noodles-zip11/LADAR2-showcase/docs/spec_freeze/02_字段表.md

# 字段表

这份文档同时承担四个作用：

- MCU 点云数据结构表
- 内部 chunk 调试字段表
- CSV 字段表
- 函数表

## 1. MCU 点云数据结构表

| 字段名 | 层级 | 类型 | 单位 | 作用 | 备注 |
| --- | --- | --- | --- | --- | --- |
| `t_sample_us` | MCU 点结构 | `uint32_t` | us | 每点时间戳 | 当前按 UART 帧中心时间估计 |
| `angle_tick` | MCU 点结构 | `uint16_t` | tick | 单圈内角度原始量 | 由连续编码器计数回推并折回单圈 |
| `angle_deg` | MCU 点结构 | `float` | deg | 角度派生量 | 由 `angle_tick` 计算 |
| `distance_cm` | MCU 点结构 | `uint16_t` | cm | 主距离字段 | 已冻结，不再使用 `distance_mm` |
| `quality` | MCU 点结构 | `uint8_t` | 无 | 强度/质量压缩值 | 供过滤与分析使用 |
| `status` | MCU 点结构 | `uint8_t` | 位标志 | 点状态 | 当前仅随成功输出的点发送，已实现使用以 `LIDAR_STATUS_ESTIMATED` 为主 |
| `tmp` | MCU 点结构 | `float` | 传感器换算值 | 温度相关原始量 | 仅保留为 MCU 内部字段，不纳入正式对外字段 |

## 2. 内部 chunk 调试字段表

| 字段名 | 层级 | 类型 | 单位 | 作用 | 备注 |
| --- | --- | --- | --- | --- | --- |
| `luna_chunk_rx_time_us` | MCU 内部 | `uint32_t` | us | chunk 接收锚点 | 仅用于估计与调试，不上 CAN |
| `luna_rx_encoder_tick16` | MCU 内部 | `uint16_t` | tick | 原始 16 位编码器计数 | 原始快照 |
| `luna_rx_encoder_count32` | MCU 内部 | `int32_t` | tick | 连续编码器累计计数 | 用于跨回绕角度回推 |
| `g_zero_offset_count32` | MCU 内部 | `int32_t` | tick | 本次运行零位偏移 | 由第一个成功输出点锁定，开机零位 |
| `g_zero_offset_valid` | MCU 内部 | `uint8_t` | 无 | 零位是否已锁定 | `0` 未锁定，`1` 已锁定 |
| `g_last_rev_id` | MCU 内部 | `int32_t` | 圈号 | 最近一次内部圈号 | 用于圈边界变化检测 |
| `g_rev_transition_cnt` | MCU 内部 | `uint32_t` | 次 | 跨圈统计计数 | `rev_id` 变化时累加 |

## 3. 内部计数器表

| 字段名 | 层级 | 类型 | 单位 | 作用 | 备注 |
| --- | --- | --- | --- | --- | --- |
| `checksum_fail_cnt` | MCU 内部 | `uint32_t` | 次 | 统计校验失败帧 | 对应帧直接丢弃，不输出点 |
| `luna_header_skip_cnt` | MCU 内部 | `uint32_t` | 次 | 统计非帧头字节跳过次数 | MCU parser 内部诊断计数，不上 CAN |
| `luna_resync_cnt` | MCU 内部 | `uint32_t` | 次 | 统计 checksum 失败后的滑动重同步次数 | MCU parser 内部诊断计数，不上 CAN |
| `luna_frame_ok_cnt` | MCU 内部 | `uint32_t` | 次 | 统计成功入点队列的点数 | MCU parser 内部诊断计数，不等同于 CAN 成功发送点数 |
| `amp_low_cnt` | MCU 内部 | `uint32_t` | 次 | 统计低幅值帧 | 对应帧直接丢弃，不输出点 |
| `too_near_cnt` | MCU 内部 | `uint32_t` | 次 | 统计过近帧 | 当前阈值按 `< 28 cm` 处理，直接丢弃 |
| `uart_chunk_drop_cnt` | MCU 内部 | `uint32_t` | 次 | UART chunk 入队失败计数 | 链路级异常，仅计数，不补点、不重发 |
| `parser_overflow_cnt` | MCU 内部 | `uint32_t` | 次 | `parser_buffer` 溢出计数 | 链路级异常，仅计数，不补点、不重发 |
| `lidar_point_drop_cnt` | MCU 内部 | `uint32_t` | 次 | 点队列发送失败计数 | 链路级异常，仅计数，不补点、不重发 |

## 4. CSV 字段表

建议 Linux/CSV 正式字段为：

| 字段名 | 产生位置 | 类型建议 | 单位 | 作用 | 备注 |
| --- | --- | --- | --- | --- | --- |
| `host_rx_time_us` | Linux | `uint64_t` | us | Linux 接收/重组时间 | 不代替 `t_sample_us` |
| `t_sample_us` | MCU -> Linux | `uint32_t` | us | MCU 每点时间戳 | 用于几何与时序恢复 |
| `angle_tick` | MCU -> Linux | `uint16_t` | tick | 角度原始量 | 正式保留，用于检测、回放与复算 |
| `angle_deg` | MCU -> Linux | `float` | deg | 角度派生量 | 正式保留，用于可视化与对外消费 |
| `distance_cm` | MCU -> Linux | `uint16_t` | cm | 主距离字段 | 已冻结 |
| `x_mm` | Linux 派生 | `float` | mm | 平面坐标 X | 由角度和距离计算 |
| `y_mm` | Linux 派生 | `float` | mm | 平面坐标 Y | 由角度和距离计算 |
| `quality` | MCU -> Linux | `uint8_t` | 无 | 质量分析 | 可用于过滤 |
| `status` | MCU -> Linux | `uint8_t` | 位标志 | 点状态 | 包含估计/异常标记 |

## 5. 字段命名冻结结论

- 正式 Linux 时间字段采用 `host_rx_time_us`
- 正式 MCU 时间字段采用 `t_sample_us`
- 正式主距离字段采用 `distance_cm`
- 内部锚点字段 `luna_chunk_rx_time_us` 不进入正式 MCU 点结构
- `distance_mm` 不再作为正式字段出现
- `tmp` 不纳入正式对外字段
- Linux CSV 保留 `angle_tick`
- Linux/对外字段保留 `angle_deg`
- `checksum` / `AMP_LOW` / `TOO_NEAR` 当前不作为成功输出点的 `status` 对外传输，而是采用“丢弃并计数”策略
- 零位冻结为“开机零位”
- 圈边界基于连续编码器计数定义，但 `rev_id` 当前只保留为内部语义

## 6. 函数表

| 函数名 | 所在文件 | 输入 | 输出 | 作用 | 备注/冻结语义 |
| --- | --- | --- | --- | --- | --- |
| `HAL_UARTEx_RxEventCallback` | `Core/Src/main.c` | `UART_HandleTypeDef *`, `Size` | 无 | 在 DMA + IDLE 回调中生成 `LidarChunk` | 采样 `luna_chunk_rx_time_us` 和连续编码器快照 |
| `micros_now` | `Core/Src/main.c` | 无 | `uint32_t` | 读取 MCU 本地微秒时间 | 用于 chunk 时间锚点 |
| `encoder_take_snapshot32` | `Core/Src/main.c` | `curr16` | `int32_t` | 维护连续编码器计数 | 处理 16 位回绕 |
| `luna_input` | `Core/Src/luna.c` | `buffer`, `size`, `chunk_start_index`, `chunk`, `motor_speed_rps` | `uint16_t` 已消费字节数 | 从 `parser_buffer` 中扫描并输出点 | 当前通过 `LunaParseState` 组织帧头搜索、校验、解码和输出；异常策略为 `checksum` / `AMP_LOW` / `TOO_NEAR` 直接丢弃并计数，同时锁定开机零位并更新内部 `rev_id` |
| `angle_from_tick` | `Core/Src/luna.c` | `tick` | `float` | 将 `angle_tick` 转成角度 | 单圈内派生量 |
| `fold_count32_to_rev` | `Core/Src/luna.c` | `count32`, `counts_per_rev` | `int32_t` | 将连续计数折回单圈 | 处理负值与回绕 |
| `LIDAR_SendCAN` | `Core/Src/can.c` | `hcan`, `pHeader`, `aData`, `pTxMailbox`, `point` | `HAL_StatusTypeDef` | 发送两帧 CAN 报文 | 不发送 `luna_chunk_rx_time_us` |
| `LidarParseTask1` | `Core/Src/freertos.c` | FreeRTOS 任务参数 | 无 | 拼接 `parser_buffer` 并调用 `luna_input` | 负责 `chunk_start_index` 传递 |
| `MotorCtrlTask1` | `Core/Src/freertos.c` | FreeRTOS 任务参数 | 无 | 计算 `m1_speed` 并维护 `g_speed_valid` | 首块/起步阶段保护依赖于此 |
