noodles-zip11/LADAR2-showcase/docs/spec_freeze/04_时间戳说明表.md

# 时间戳语义说明表

这份文档定义各时间字段的来源、物理含义和用途边界。

## 1. 时间字段清单

| 字段名 | 产生位置 | 类型 | 单位 | 含义 | 是否对外传输 |
| --- | --- | --- | --- | --- | --- |
| `t_sample_us` | MCU | `uint32_t` | us | 按 UART 帧中心时间估计得到的每点时间戳 | 是 |
| `luna_chunk_rx_time_us` | MCU | `uint32_t` | us | 当前 DMA + IDLE chunk 的接收锚点 | 否 |
| `host_rx_time_us` | Linux | `uint64_t` | us | Linux 接收并完成该点重组时的本地时间 | 仅 Linux/CSV |

## 2. 语义冻结结论

### 2.1 `t_sample_us`

- 来源：MCU
- 当前定义：按 UART 帧中心时间估计得到的每点时间戳
- 用途：
  - 点序恢复
  - 角度配对
  - 点云几何计算
- 边界：
  - 不是 Linux 接收时间
  - 不是传感器真实发光瞬间
  - 当前属于估计值，不是硬件直接测得值

### 2.2 `luna_chunk_rx_time_us`

- 来源：MCU
- 当前定义：在 `HAL_UARTEx_RxEventCallback` 中记录的 chunk 接收锚点
- 用途：
  - 当前 chunk 内每帧 `t_sample_us` 的回推基准
  - 当前 chunk 内每帧 `angle_tick` 的回推基准
  - 调试与诊断
- 边界：
  - 不进入正式 MCU 点结构
  - 不进入 CAN 报文
  - 不进入正式 CSV 字段

### 2.3 `host_rx_time_us`

- 来源：Linux
- 当前定义：Linux 接收并完成该点重组时的本地时间
- 用途：
  - 链路延迟分析
  - 抖动分析
  - 回放与日志对齐
- 边界：
  - 不代替 `t_sample_us`
  - 不参与 MCU 侧几何计算

## 3. 当前代码对应关系

- `HAL_UARTEx_RxEventCallback` 记录 `luna_chunk_rx_time_us`
- `luna_input` 基于 `chunk_start_index`、`luna_chunk_rx_time_us` 和 UART 字节时间回推 `t_sample_us`
- `luna_input` 基于 `luna_rx_encoder_count32` 和 `m1_speed` 回推 `angle_tick`
- `luna_input` 当前通过 `LunaParseState` 状态机组织解析路径；状态机只影响内部解析流程，不改变成功点的时间戳定义
- `luna_input` 对 `checksum` / `AMP_LOW` / `TOO_NEAR` 异常帧采用“直接丢弃并计数”策略，不为其生成正式点时间戳
- `luna_input` 在第一个成功输出点处锁定 `g_zero_offset_count32`
- `luna_input` 基于 `sample_count32 - g_zero_offset_count32` 计算 `angle_tick`
- `luna_input` 基于 `rev_id = floor((sample_count32 - g_zero_offset_count32) / counts_per_rev)` 判断圈边界

## 4. 退化路径说明

- 当首块或 `g_speed_valid == 0` 时：
  - `t_sample_us` 退化为基于 chunk 锚点的估计值
  - `angle_tick` 退化为 chunk 级角度估计
  - `status` 打 `LIDAR_STATUS_ESTIMATED`
- 当当前帧跨 chunk 时：
  - 当前实现也走估计路径
  - `status` 打 `LIDAR_STATUS_ESTIMATED`

## 5. 与对外字段的关系

- `t_sample_us` 是正式对外字段
- `host_rx_time_us` 是正式 Linux/CSV 字段
- `angle_tick` 正式保留，用于检测与复算
- `angle_deg` 正式保留，并继续通过 CAN 对外发送
- `tmp` 不纳入正式对外字段
- 被 `checksum_fail_cnt`、`amp_low_cnt`、`too_near_cnt` 统计到的异常帧不进入正式对外字段集合
- `g_zero_offset_count32`、`g_zero_offset_valid`、`g_last_rev_id`、`g_rev_transition_cnt` 不进入正式对外字段集合
- `uart_chunk_drop_cnt`、`parser_overflow_cnt`、`lidar_point_drop_cnt` 仅作为链路级计数器保留，当前不做补点、不做重发、不做插值

## 6. 零位与圈边界语义

- 零位已冻结为“开机零位”
- 当前实现以第一个成功输出点的 `sample_count32` 作为本次运行零位
- `angle_tick = fold_count32_to_rev(sample_count32 - g_zero_offset_count32, counts_per_rev)`
- `angle_deg` 由该 `angle_tick` 派生
- 圈边界基于相对零位后的连续计数定义
- 当 `rev_id` 变化时，表示跨过圈边界
- `rev_id` 当前仅用于 MCU 内部统计与调试，不作为正式对外字段

## 7. 不建议的写法

- 不要把 `host_rx_time_us` 写成 `host_rx_time`
- 不要把 `host_rx_time_us` 当作测量时间
- 不要把 `luna_chunk_rx_time_us` 当作正式点字段
- 不要把 MCU 本地 us 与 Linux 本地 us 直接做绝对时间比较
