noodles-zip11/LADAR2-showcase/docs/m9/runs/rule_based_v1/replay_sets/can_distance_20260507_141150/can_distance_20260507_141150.m9_report.md

# M9 Rule Quality Gate Appendix Report - can_distance_20260507_141150

- Input: `docs\m8\datasets\replay_sets\can_distance_20260507_141150\can_distance_20260507_141150.csv`
- Filtered CSV: `docs\m9\runs\rule_based_v1\replay_sets\can_distance_20260507_141150\can_distance_20260507_141150.m9_filtered.csv`

## Metrics

| metric | value |
| --- | ---: |
| `total_rows` | 5220 |
| `valid_inputs` | 5220 |
| `kept_points` | 5214 |
| `filtered_points` | 6 |
| `filtered_ratio` | 0.00114943 |
| `status_estimated_count` | 5220 |
| `status_estimated_ratio` | 1 |
| `continuity_issue_count` | 0 |
| `continuity_issue_ratio` | 0 |
| `stability_issue_count` | 6 |
| `stability_issue_ratio` | 0.00114943 |

## Rule Reasons

| reason | count |
| --- | ---: |
| `unstable_angle_bin` | 6 |

## Boundary

- This is rule-level point quality screening, not scene ground truth.
- `status=0x08` is tracked as an estimated flag and is not treated as an alert by itself.
- The stability rule uses repeated distance behavior within angle bins; moving targets or changed scenes still need manual labels.
