noodles-zip11/LADAR2-showcase/docs/m9/runs/rule_based_v1/replay_sets/can_distance_20260509_214813/can_distance_20260509_214813.m9_report.md

# M9 Rule Quality Gate Appendix Report - can_distance_20260509_214813

- Input: `docs\m8\datasets\replay_sets\can_distance_20260509_214813\can_distance_20260509_214813.csv`
- Filtered CSV: `docs\m9\runs\rule_based_v1\replay_sets\can_distance_20260509_214813\can_distance_20260509_214813.m9_filtered.csv`

## Metrics

| metric | value |
| --- | ---: |
| `total_rows` | 15671 |
| `valid_inputs` | 15671 |
| `kept_points` | 15505 |
| `filtered_points` | 166 |
| `filtered_ratio` | 0.0105928 |
| `status_estimated_count` | 15671 |
| `status_estimated_ratio` | 1 |
| `continuity_issue_count` | 44 |
| `continuity_issue_ratio` | 0.00280773 |
| `stability_issue_count` | 141 |
| `stability_issue_ratio` | 0.00899751 |

## Rule Reasons

| reason | count |
| --- | ---: |
| `distance_jump` | 44 |
| `unstable_angle_bin` | 141 |

## Boundary

- This is rule-level point quality screening, not scene ground truth.
- `status=0x08` is tracked as an estimated flag and is not treated as an alert by itself.
- The stability rule uses repeated distance behavior within angle bins; moving targets or changed scenes still need manual labels.
