noodles-zip11/LADAR2-showcase/docs/m9/runs/rule_based_v1/replay_sets/can_distance_20260509_222646/can_distance_20260509_222646.m9_report.md

# M9 Rule Quality Gate Appendix Report - can_distance_20260509_222646

- Input: `docs\m8\datasets\replay_sets\can_distance_20260509_222646\can_distance_20260509_222646.csv`
- Filtered CSV: `docs\m9\runs\rule_based_v1\replay_sets\can_distance_20260509_222646\can_distance_20260509_222646.m9_filtered.csv`

## Metrics

| metric | value |
| --- | ---: |
| `total_rows` | 20881 |
| `valid_inputs` | 20881 |
| `kept_points` | 20597 |
| `filtered_points` | 284 |
| `filtered_ratio` | 0.0136009 |
| `status_estimated_count` | 20881 |
| `status_estimated_ratio` | 1 |
| `continuity_issue_count` | 18 |
| `continuity_issue_ratio` | 0.000862028 |
| `stability_issue_count` | 271 |
| `stability_issue_ratio` | 0.0129783 |

## Rule Reasons

| reason | count |
| --- | ---: |
| `distance_jump` | 18 |
| `unstable_angle_bin` | 271 |

## Boundary

- This is rule-level point quality screening, not scene ground truth.
- `status=0x08` is tracked as an estimated flag and is not treated as an alert by itself.
- The stability rule uses repeated distance behavior within angle bins; moving targets or changed scenes still need manual labels.
