noodles-zip11/LADAR2-showcase/docs/m9/runs/rule_based_v1/replay_sets/can_distance_20260509_223115/can_distance_20260509_223115.m9_report.md

# M9 Rule Quality Gate Appendix Report - can_distance_20260509_223115

- Input: `docs\m8\datasets\replay_sets\can_distance_20260509_223115\can_distance_20260509_223115.csv`
- Filtered CSV: `docs\m9\runs\rule_based_v1\replay_sets\can_distance_20260509_223115\can_distance_20260509_223115.m9_filtered.csv`

## Metrics

| metric | value |
| --- | ---: |
| `total_rows` | 8691 |
| `valid_inputs` | 8691 |
| `kept_points` | 8581 |
| `filtered_points` | 110 |
| `filtered_ratio` | 0.0126568 |
| `status_estimated_count` | 8691 |
| `status_estimated_ratio` | 1 |
| `continuity_issue_count` | 10 |
| `continuity_issue_ratio` | 0.00115062 |
| `stability_issue_count` | 101 |
| `stability_issue_ratio` | 0.0116212 |

## Rule Reasons

| reason | count |
| --- | ---: |
| `distance_jump` | 10 |
| `unstable_angle_bin` | 101 |

## Boundary

- This is rule-level point quality screening, not scene ground truth.
- `status=0x08` is tracked as an estimated flag and is not treated as an alert by itself.
- The stability rule uses repeated distance behavior within angle bins; moving targets or changed scenes still need manual labels.
