noodles-zip11/LADAR2-showcase/docs/m9/runs/rule_based_v1/replay_sets/can_distance_20260510_000136/can_distance_20260510_000136.m9_report.md

# M9 Rule Quality Gate Appendix Report - can_distance_20260510_000136

- Input: `docs\m8\datasets\replay_sets\can_distance_20260510_000136\can_distance_20260510_000136.csv`
- Filtered CSV: `docs\m9\runs\rule_based_v1\replay_sets\can_distance_20260510_000136\can_distance_20260510_000136.m9_filtered.csv`

## Metrics

| metric | value |
| --- | ---: |
| `total_rows` | 33304 |
| `valid_inputs` | 33304 |
| `kept_points` | 32730 |
| `filtered_points` | 574 |
| `filtered_ratio` | 0.0172352 |
| `status_estimated_count` | 33304 |
| `status_estimated_ratio` | 1 |
| `continuity_issue_count` | 93 |
| `continuity_issue_ratio` | 0.00279246 |
| `stability_issue_count` | 491 |
| `stability_issue_ratio` | 0.014743 |

## Rule Reasons

| reason | count |
| --- | ---: |
| `distance_jump` | 90 |
| `isolated_no_neighbor` | 3 |
| `unstable_angle_bin` | 491 |

## Boundary

- This is rule-level point quality screening, not scene ground truth.
- `status=0x08` is tracked as an estimated flag and is not treated as an alert by itself.
- The stability rule uses repeated distance behavior within angle bins; moving targets or changed scenes still need manual labels.
