noodles-zip11/LADAR2-showcase/checkpoint_lidar_can_linux_slim.md

# 基于 CAN 与 Linux 上位机的 2D LiDAR 感知系统 Checkpoint（精简执行版）

**状态：第一版主线收敛**

> 目标：先做成一个可量化、可复现、可面试的工程项目，优先打通核心链路，不在第一阶段引入 MQTT、云端与额外 IoT 包装。

## 0. 项目定位与边界冻结

### 0.1 项目主线
- 旋转式 2D LiDAR 数据采集
- 电机转速控制与角度同步
- CAN 双节点通信
- Linux 上位机实时显示、存储与回放
- 系统稳定性与误差验证

### 0.2 第一阶段必要目标
- 角度同步必须单独设计、验证并写入首页
- 误差来源与预算必须单独列出并持续修正
- 数据链路设计必须明确到帧格式、字段和时间戳
- 上述三项与核心功能同级，不作为“后面再补的文档”

### 0.3 第一阶段明确不做
- MQTT 上云
- 云端平台接入
- 远程控制面板
- 复杂 IoT 展示包装

### 0.4 输出目标
- 360° 单线扫描点云（2D）
- 主控与网关之间稳定 CAN 通信
- Linux 上位机实时显示点云
- 可导出测试数据与误差统计结果

### 0.5 冻结指标（建议）
- 扫描频率：5~10 Hz（可调）
- 角度分辨率：<= 2°
- 点云刷新率：>= 10 FPS（上位机目标）
- 丢包率：< 0.1%
- 连续运行稳定性：>= 4h，目标 8h

### 0.6 交付物
- `README.md`
- 系统框图
- 数据流图
- 时序图
- 测试记录与误差统计表
- 误差来源与预算页
- 数据包与时间戳设计页
- 最小可运行里程碑页

---

## 1. 差异化定位（相对小车项目）

### 1.1 本项目重点
- 感知链路
- 数据通信
- Linux 工具链
- 可观测性与稳定性验证

### 1.2 不重复强调的内容
- 不把项目主卖点放在“小车控制”
- 不把项目讲成“又一个 FreeRTOS 多任务控制系统”
- 不把重点放在花哨功能堆叠

### 1.3 面试表述建议
> 这是一个以感知链路和通信链路为核心的 2D LiDAR 工程项目，重点在于测距采集、角度同步、CAN 分发、Linux 可视化和稳定性验证。

---

## 2. 器件与系统方案 Checkpoint

### 2.1 主控与通信选型
- 主控 MCU：`STM32F407VET6`
  - 关注点：定时器、DMA、CAN 资源、RAM 余量
- CAN 收发器：`SN65HVD230 / VP230`
  - 关注点：3.3V 电平兼容、总线稳定性、ESD 能力
- Linux 侧接入方式：
  - 方案 A：USB-CAN
  - 方案 B：串口桥接到 Linux

### 2.2 传感器与执行器选型
- ToF 传感器：`TF-Luna` 或 `VL53L1X`
- 电机：`N20 + 编码器`
- 滑环：满足旋转供电与信号传输

### 2.3 验收标准
- 输出《选型对比表》
- 输出《接口定义表》
- 输出《电源预算表》

---

## 3. 误差来源与预算（必要页）

### 3.1 目标
- 不只列“误差存在”，而是明确误差来源、估算方法、量级和控制手段
- 初版先给工程预算，实测后再用数据回填修正

### 3.2 ToF 测距误差
- 来源：传感器固有精度、反射率差异、入射角、环境光、盲区与采样噪声
- 预算写法：按传感器典型精度和最差场景分别给出区间
- 记录项：静态白板、深色表面、斜入射表面的距离偏差
- 控制手段：限工作距离、滤除异常值、分材质测试、必要时滑动平均

### 3.3 编码器角度误差
- 来源：编码器线数有限、机械间隙、安装偏心、计数抖动
- 预算写法：
  - 量化分辨率误差：`360 / 编码器每圈总计数`
  - 机械误差单独估计并与量化误差叠加
- 记录项：单圈角度偏差、重复定位误差、零位漂移
- 控制手段：提高计数分辨率、做零位校准、改善安装同轴度

### 3.4 转速波动引入的时间误差
- 来源：电机稳速不足、负载变化、控制环响应滞后
- 影响：距离采样时刻与角度估计不再严格对应，导致点云“扭曲”
- 预算写法：
  - 记录目标转速与实际转速偏差
  - 用采样周期乘角速度波动，折算成角度误差
- 记录项：稳态波动、加减速过渡、长时间漂移
- 控制手段：闭环稳速、固定采样节拍、必要时按时间戳插值修正角度

### 3.5 CAN/串口传输延迟
- 来源：UART 帧时长、DMA 缓冲等待、CAN 仲裁与重发、上位机调度延迟
- 影响：显示和记录端看到的是“延迟后的点”，严重时影响时序分析
- 预算写法：分别统计
  - LiDAR 到 MCU 的串口接收延迟
  - MCU 到 Linux 的 CAN 或串口传输延迟
  - Linux 解析与绘图延迟
- 记录项：平均延迟、最大延迟、抖动范围
- 控制手段：加时间戳、减小缓冲批量、将传输延迟与测量误差分开讨论

### 3.6 坐标转换误差
- 来源：角度误差和距离误差共同投影到 `x/y`
- 预算写法：
  - 近距离时距离误差更显著
  - 远距离时角度误差对横向坐标影响更明显
- 记录项：典型距离点在 `x/y` 平面的偏移量
- 控制手段：在文档中给出误差传播说明，并用实测点验证

### 3.7 建议输出表
- 字段：误差源、理论预算、测试方法、实测均值、实测最大值、改进措施

---

## 4. 数据包与时间戳设计（必要页）

### 4.1 设计原则
- 每一级链路都要有清晰输入和输出格式
- 时间戳尽早产生，尽量在靠近采样的位置生成
- 区分“原始测量时间”和“传输到达时间”

### 4.2 LiDAR 原始帧格式
- 建议字段：帧头、长度、距离值、强度值（若有）、校验、帧尾
- 若传感器已有固定协议：保留原始字段定义，不自行发明新格式
- 记录内容：
  - 原始字节流示例
  - 字段偏移说明
  - 校验失败处理策略

### 4.3 MCU 内部数据结构
```c
typedef struct {
    uint32_t t_sample_us;
    uint16_t angle_tick;
    float angle_deg;
    uint16_t distance_cm;
    uint8_t quality;
    uint8_t status;
} lidar_point_t;
```
- `t_sample_us`：MCU 侧采样或完成配对时的时间戳
- `angle_tick`：保留原始编码器计数，便于回溯
- `angle_deg`：上层使用的角度值
- `status`：标记正常、校验失败、超量程、插值等状态

### 4.4 CAN 报文格式
- 由于 CAN 单帧有效载荷有限，建议拆分为定长字段
- 方案示例：
- 帧 A：`point_id + angle_tick + distance_cm`
  - 帧 B：`point_id + t_sample_us_low + quality + status`
- 如果用 CAN FD，可合并更多字段
- 必须定义：
  - 报文 ID
  - 字节序
  - 缩放规则
  - 丢帧后的重组策略

### 4.5 上位机解析格式
- 内存结构建议字段：
  - `host_rx_time`
  - `t_sample_us`
  - `angle_deg`
- `distance_cm`
  - `x_mm`
  - `y_mm`
  - `quality`
  - `status`
- 文件保存格式建议：CSV 先行，字段固定，便于回放和后处理

### 4.6 时间戳放置建议
- 第一时间戳：MCU 侧，放在距离值与角度值完成配对时生成
- 第二时间戳：Linux 侧，记录报文接收时间
- 不建议只用 Linux 接收时间代替测量时间
- 若资源有限，优先保留 MCU 时间戳

### 4.7 需要写进文档的表
- 《LiDAR 原始帧定义表》
- 《MCU 点云数据结构表》
- 《CAN 报文定义表》
- 《上位机 CSV 字段表》
- 《时间戳语义说明表》

---

## 5. 硬件设计 Checkpoint

### 5.1 原理图
- MCU 最小系统
- 电机驱动
- 编码器输入
- LiDAR 接口
- CAN 接口
- 调试串口与 SWD

### 5.2 PCB 与抗干扰
- 电源区、驱动区、MCU 区、通信区分区
- CAN 差分对优先保证走线质量
- 电机驱动回路与敏感信号隔离
- 关键测试点预留

### 5.3 验收标准
- ERC/DRC 无 Error
- 可稳定下载和串口打印
- 电机启停不导致 MCU 复位

---

## 6. 板级 bring-up Checkpoint

### 6.1 上电自检
- 检查 3.3V/5V 纹波
- 检查静态电流与温升
- 检查下载、串口、调试接口

### 6.2 外设逐项调通
- LiDAR 数据接收
- PWM 输出
- 编码器测速
- CAN 收发
- 电机启停与调速

### 6.3 验收标准
- 每个模块都有最小测试程序
- 每个模块都有日志或截图记录

---

## 7. 固件主线 Checkpoint

### 7.1 驱动层
- UART DMA + IDLE 接收 LiDAR 数据
- 编码器测速
- PWM 调速
- CAN 收发与过滤器

### 7.2 最小任务集
- `MotorCtrlTask`
- `LidarParseTask`
- `CanTxTask`
- `DiagLogTask`（可选但推荐）

### 7.3 核心规则
- 中断与任务之间仅通过 Queue/StreamBuffer 传递数据
- 驱动接口统一：`init/start/read/write`
- 错误码和状态码可追踪

### 7.4 验收标准
- 无明显共享变量竞争
- 能输出队列高水位或缓冲区占用统计
- 异常帧可识别并丢弃

---

## 8. 感知与同步 Checkpoint

### 8.1 LiDAR 数据解析
- 解析距离数据帧
- 处理错帧、截断帧、校验错误
- 对异常值做过滤

### 8.2 电机转速控制
- 实现稳定转速控制
- 记录目标转速与实际转速偏差
- 输出调参记录

### 8.3 角度同步
- 用编码器或等效方法建立距离值与角度的对应关系
- 说明一圈采样内的角度映射方法
- 明确同步误差来源
- 说明是否使用时间戳插值或固定节拍配对

### 8.4 坐标变换
- 极坐标转直角坐标
- 输出点云数据结构供 CAN 或上位机使用

### 8.5 验收标准
- 输出滤波前后对比图
- 输出转速响应曲线
- 输出角度同步说明与误差预算

---

## 9. CAN 通信 Checkpoint

### 9.1 最小网络结构
- 节点 1：LiDAR 主控节点
- 节点 2：Linux 侧接入节点或网关节点

### 9.2 通信内容
- 角度
- 距离
- 状态码
- 错误计数或诊断字段
- 必要时间戳字段

### 9.3 关键验证项
- 标准帧稳定收发
- 过滤器命中正确
- 连续传输下无明显丢帧
- 异常帧和总线错误可记录

### 9.4 验收标准
- 输出 CAN 报文定义表
- 输出抓包记录或日志
- 输出错误计数统计

---

## 10. Linux 上位机 Checkpoint

### 10.1 数据接收工具
- 技术栈建议：`Python + PySerial` 或 `python-can`
- 功能：
  - 接收数据
  - 解析数据帧
  - 保存 CSV

### 10.2 实时显示
- 技术栈建议：`PyQtGraph` 优先，`Matplotlib` 作为简化备选
- 功能：
  - 2D 点云实时显示
  - 刷新率统计
  - 支持回放历史数据

### 10.3 工程化交付
- `requirements.txt`
- 一键运行脚本
- 示例数据文件
- 基本使用说明

### 10.4 验收标准
- 新环境 30 分钟内可复现演示
- 可完成“接收-显示-存储-回放”闭环

---

## 11. 最小可运行里程碑（必要页）

### 11.1 M1：LiDAR 原始距离采集成功
- 能稳定收到原始数据帧
- 能识别错帧和校验失败
- 输出原始日志样例

### 11.2 M2：电机稳速 + 编码器测速
- 电机能稳定转动
- 实际转速可测可画曲线
- 能说明稳态误差与波动范围

### 11.3 M3：距离-角度配对成功
- 每个距离值都能关联角度值
- 能输出一圈内的点云原始列表
- 能解释配对时刻和时间戳语义

### 11.4 M4：Linux 闭环
- 主控稳定发、接收端稳定收
- 报文格式固定并可抓包验证
- 关键状态位可见
- 能实时解析并显示 2D 点云
- 能保存 CSV
- 能回放历史数据

### 11.5 M6：长稳与压测
- 连续运行 >= 4h
- 记录丢包、刷新率、温升和异常恢复
- 输出测试结论

### 11.6 执行原则
- 每个里程碑都必须有截图、日志或数据文件作为完成证据
- 未完成上一个里程碑，不进入下一个里程碑的复杂扩展

---

## 12. 系统联调与压测 Checkpoint

### 12.1 长稳测试
- 连续运行 >= 4h，目标 8h
- 记录：
  - 丢包率
  - 转速波动
  - 点云刷新率
  - 错误恢复次数
  - 温升

### 12.2 场景测试
- 静态目标
- 移动目标
- 不同材质反射面

### 12.3 失效模式验证
- 电源抖动
- CAN 干扰
- 串口噪声
- 传感器异常数据

### 12.4 验收标准
- 无崩溃、死锁、严重漂移
- 错误可观测、可记录、可恢复

---

## 13. 简历与面试交付 Checkpoint

### 13.1 必备内容
- 一张系统框图
- 一张数据流图
- 一张点云显示截图
- 一页测试结果总结
- 一段 1~3 分钟演示视频

### 13.2 简历表述建议
> 设计并实现基于 STM32 的 2D LiDAR 感知系统，完成 LiDAR 数据采集、电机角度同步、CAN 节点通信与 Linux 上位机实时点云显示，并通过长稳与误差测试验证系统可靠性。

### 13.3 面试重点准备
- 为什么保留 CAN、不急着上云
- 角度同步怎么做
- 丢包和错帧如何处理
- 时间戳为什么这样设计
- Linux 上位机为什么这样设计
- 如何证明系统稳定

---

## 14. 后续扩展（第一阶段完成后再加）

### 14.1 通信扩展
- MQTT 网关桥接
- 云端数据上传
- 多节点 CAN 网络扩展

### 14.2 AI 扩展策略（第二阶段，Linux 侧优先）
- AI 第一落点放在 Linux 上位机，不在第一阶段直接部署到 MCU
- 先利用已有的 `CSV / 实时接收 / 存储 / 回放` 链路做数据集、离线训练和验证
- 先证明 AI 功能确实优于固定阈值或简单规则，再考虑轻量化下沉部署

#### 14.2.1 第一优先级：点级质量判断
- 目标：判断单点或局部点是否有效、异常或可疑
- 推荐输入特征：
  - 当前距离
  - 前后点差分
  - 连续几圈是否稳定
  - `quality` 或幅值
  - 邻域连续性
  - 转速波动或时间戳相关特征
- 输出建议：
  - 二分类：有效 / 无效
  - 或三分类：有效 / 可疑 / 无效
- 选择原因：
  - 数据最好采
  - 标签定义最清楚
  - 可直接和规则滤波做对比
  - 最适合后续轻量模型或 MCU 端部署尝试

#### 14.2.2 第二优先级：障碍物区域判断 / 风险分区
- 不直接判断单个点，而是判断前方某一小片区域是否危险
- 可将前方按角度划分成若干扇区，再根据局部点云特征输出：
  - 安全
  - 可疑
  - 危险
- 该方向适合后续往室内低速设备的障碍感知节点扩展
- 前提是点级清洗已经稳定，否则上层判断会被底层噪声拖垮

#### 14.2.3 第三优先级：简单目标检测 / 动静态区分
- 该方向接近点云聚类、简单目标检测、障碍物跟踪
- 可让模型或规则判断：
  - 这团点像不像真实障碍物
  - 这是静态背景还是移动目标
  - 这一圈和上一圈相比是否出现异常变化
- 该方向门槛更高，因为需要更稳定的点云、更好的连续帧数据和更明确的标签定义
- 因此放在点级质量判断和风险分区之后

#### 14.2.4 模型与部署原则
- Linux 侧优先，先做离线验证，再决定是否做实时推理
- 先做规则基线，再尝试轻量模型
- 模型优先考虑：
  - Logistic Regression
  - 小型决策树 / 随机森林
  - LightGBM / XGBoost 小模型
  - Tiny MLP
- 暂不优先考虑重型深度学习模型
- 只有在 Linux 侧验证出明确价值后，才考虑 MCU 侧轻量化部署

### 14.3 工具扩展
- 更完整的 Linux GUI
- 参数在线配置
- 历史数据管理与分析面板

### 14.4 原则
- 只有在核心链路稳定后才增加这些内容
- 所有扩展项都不能影响第一阶段主线交付

---

## 15. 执行顺序建议

1. 先打通 LiDAR 原始采集。
2. 再完成电机稳速和编码器测速。
3. 然后完成距离-角度配对与时间戳设计。
4. 再完成 CAN 双节点稳定通信。
5. 然后做 Linux 接收、显示、存储、回放。
6. 再做长稳测试、误差统计和失效验证，积累可回放数据。
7. 第二阶段先在 Linux 侧建立“录制-回放-标注-评估”闭环。
8. AI 第一优先级先做点级质量判断。
9. AI 第二优先级再做障碍物区域判断 / 风险分区。
10. AI 第三优先级最后再考虑简单目标检测 / 动静态区分。
11. MQTT、云端、IoT 包装全部放到更后面的扩展阶段。
