noodles-zip11/LADAR2-showcase/docs/m3/05_错误统计与恢复样例.md

# M3 错误统计与恢复样例

## 1. 结论

当前已经归档 MCU 侧故障态与 ACK fault recovery `DiagLogTask` 样例，能够证明：

- `DiagLogTask` 的 M3 CSV 已在 MCU 侧实际输出
- CAN 发送失败计数会持续增长
- CAN 错误位图和错误中断计数会持续刷新
- 恢复后 `can_tx_ok_point_cnt` 重新增长，错误计数停止增长

本次故障注入方式没有触发 Bus-Off，因此没有证明：

- `HAL_CAN_ERROR_BOF` 出现
- `can_recovery_cnt` 在 Bus-Off 恢复后增加

此外，当前已经归档一段 MCU 正常态 `DiagLogTask` 样例，可作为正常链路对照。

因此，本页当前可以作为“正常态 + ACK 故障态 + ACK 恢复态样例页”。`Bus-Off -> recovery` 不作为 M3 当前收尾证据。

## 2. 当前归档文件

- `docs/m3/data/diag_m3_fault_20260328_excerpt.csv`
- `docs/m3/data/diag_m3_normal.csv`
- `docs/m3/data/diag_m3_ack_fault_recovery_excerpt.csv`

## 3. 样例片段

```text
tick_ms,lidar_chunk_q_depth,lidar_chunk_q_hwm,uart_chunk_drop_cnt,uart_chunk_oversize_cnt,parser_overflow_cnt,checksum_fail_cnt,amp_low_cnt,too_near_cnt,lidar_point_q_depth,lidar_point_q_hwm,lidar_point_drop_cnt,can_tx_ok_point_cnt,can_tx_fail_point_cnt,can_tx_fail_frame_cnt,can_last_error_code,can_error_irq_cnt,can_bus_off_cnt,can_recovery_cnt
190070,0,1,0,0,0,0,8,21,0,1,0,5576,13430,13430,0x00200063,503636,0,0
191076,0,1,0,0,0,0,8,21,0,1,0,5576,13531,13531,0x00200063,507418,0,0
192082,0,1,0,0,0,0,8,21,0,1,0,5576,13632,13632,0x00200063,511200,0,0
```

## 4. 样例解读

从这段故障态样例可以直接看到：

- `can_tx_ok_point_cnt` 固定在 `5576`
- `can_tx_fail_point_cnt` 持续增加
- `can_tx_fail_frame_cnt` 持续增加
- `can_error_irq_cnt` 持续增加
- `can_last_error_code` 持续保持为非零值 `0x00200063`
- `can_bus_off_cnt=0`
- `can_recovery_cnt=0`

这说明当前故障更像是“持续错误风暴”而不是“已进入并退出 Bus-Off”的闭环。

## 5. `can_last_error_code` 粗解

当前样例中的：

- `0x00200063`

至少包含以下错误位：

- `0x00000001`：`HAL_CAN_ERROR_EWG`
- `0x00000002`：`HAL_CAN_ERROR_EPV`
- `0x00000020`：`HAL_CAN_ERROR_ACK`
- `0x00000040`：`HAL_CAN_ERROR_BR`
- `0x00200000`：`HAL_CAN_ERROR_PARAM`

这说明当前链路中至少出现了：

- Error Warning
- Error Passive
- ACK 错误
- Bit Recessive 错误
- 参数错误位

当前样例中没有看到：

- `HAL_CAN_ERROR_BOF`

因此本样例不能用于证明 `Bus-Off -> recovery`。

## 6. ACK fault -> recovery 样例

文件：

- `docs/m3/data/diag_m3_ack_fault_recovery_excerpt.csv`

恢复段片段：

```text
522090,0,1,0,0,0,0,0,14,0,1,0,3552,48870,48870,0x00200023,1867497,0,0
529132,0,1,0,0,0,0,0,14,0,1,0,4260,48870,48870,0x00200023,1867497,0,0
```

故障段片段：

```text
531144,0,1,0,0,0,0,0,14,0,1,0,4335,48997,48997,0x00200023,1872423,0,0
548246,0,1,0,0,0,0,0,14,0,1,0,4335,50716,50716,0x00200023,1938710,0,0
```

再次恢复段片段：

```text
551264,0,1,0,0,0,0,0,14,0,1,0,4365,50990,50990,0x00200023,1949121,0,0
561324,0,1,0,0,0,0,0,14,0,1,0,5376,50990,50990,0x00200023,1949121,0,0
```

解读：

- 恢复段：`can_tx_ok_point_cnt` 增长，`can_tx_fail_point_cnt`、`can_tx_fail_frame_cnt`、`can_error_irq_cnt` 停止增长
- 故障段：`can_tx_ok_point_cnt` 基本停住，`can_tx_fail_point_cnt`、`can_tx_fail_frame_cnt`、`can_error_irq_cnt` 持续增长
- 再次恢复段：`can_tx_ok_point_cnt` 重新增长，错误计数再次停止增长

## 7. 当前边界

本页已经覆盖：

- 正常态统计样例
- 故障态统计样例
- ACK fault -> recovery 板级实测样例

本页仍未覆盖：

- Bus-Off recovery 行为；本次故障注入方式未触发 `HAL_CAN_ERROR_BOF`

## 7. 正常态对照样例

文件：

- `docs/m3/data/diag_m3_normal.csv`

片段：

```text
24128,0,1,0,0,0,0,0,3,0,1,0,2378,0,0,0x00000000,0,0,0
25133,0,1,0,0,0,0,0,3,0,1,0,2478,0,0,0x00000000,0,0,0
26137,0,1,0,0,0,0,0,3,0,1,0,2579,0,0,0x00000000,0,0,0
```

解读：

- `can_tx_ok_point_cnt` 持续增长
- `can_tx_fail_point_cnt=0`
- `can_tx_fail_frame_cnt=0`
- `can_last_error_code=0x00000000`
- `can_error_irq_cnt=0`
- `can_bus_off_cnt=0`
- `can_recovery_cnt=0`

这说明正常链路下 MCU 侧 M3 诊断日志口径是稳定且自洽的。

当前 M3 收口采用 ACK fault -> recovery 证据，不再把 Bus-Off recovery 作为当前阶段阻塞项。
