noodles-zip11/LADAR2-showcase/docs/m5/05_current_run_summary.md

# M5 当前实测基线

## 1. 本轮结论

截至 2026-05-07，M5 已完成一轮可用的短长稳基线记录。

本轮实际运行约 1h42min，作为 M6 几何质量与同步优化前的短长稳基线接受。当前不再补跑 2h，对外不写成“已完成 2h 长稳”。

## 2. 运行信息

| 项目 | 值 |
| --- | --- |
| run_id | `m5_20260507_145736` |
| 运行目录 | `docs/m5/runs/m5_20260507_145736/` |
| 开始时间 | `2026-05-07T14:57:36` |
| 结束时间 | `2026-05-07T16:39:32` |
| 实际运行时长 | `6116.0 s` |
| 数据有效时长 | `6115.7 s` |
| 采集点数 | `612466` |

## 3. 核心指标

| 指标 | 本次值 |
| --- | ---: |
| 点云刷新率 | `100.147 Hz` |
| CAN 重组丢包事件 | `7` |
| CAN 重组丢包率 | `0.001143%` |
| 重组 timeout | `7` |
| overwrite_a | `0` |
| overwrite_b | `0` |
| 结束 pending 半帧 | `0` |
| 平均转速 | `9.026 rpm` |
| 转速标准差 | `1.485 rpm` |
| 转速 p95 偏差 | `3.887 rpm` |

## 4. 证据文件

- `docs/m5/runs/m5_20260507_145736/m5_long_run_report.md`
- `docs/m5/runs/m5_20260507_145736/baseline_metrics.md`
- `docs/m5/runs/m5_20260507_145736/test_record.md`
- `docs/m5/runs/m5_20260507_145736/data/can_points_m5_20260507_145736.csv`
- `docs/m5/runs/m5_20260507_145736/data/can_points_m5_20260507_145736_summary.txt`
- `docs/m5/runs/m5_20260507_145736/data/m5_interval_samples.csv`
- `docs/m5/runs/m5_20260507_145736/logs/m5_events.log`

## 5. 边界说明

- 本轮不接 UART3。
- 本轮不做温升统计。
- 本轮不证明盒内几何形状正确；盒内点云近场形状只用于观察扫描是否持续。
- 几何形状、直线度、闭合度和环境轮廓质量放到 M6。
