noodles-zip11/LADAR2-showcase/docs/reacquaintance/00_快速回顾索引.md

# LADAR2 快速回顾索引

更新时间：2026-04-20

这组文档用于帮你在一个月没看项目后快速恢复上下文。内容综合了三类来源：

- 当前仓库代码：`Core/Src/*.c`、`Core/Inc/*.h`、`can_recv4.py`
- 已归档文档：`docs/spec_freeze/`、`docs/m1/`、`docs/m2/`、`docs/m3/`、`docs/m4/`
- Notion 计划：`LADAR2 实施计划（按当前进展收口版）`

Notion 源页：

- <https://www.notion.so/32dde3aefb83818e8fcfd1360c409870>

## 阅读顺序

1. [01 数据流动链路](./01_数据流动链路.md)
2. [02 MCU 代码逻辑](./02_MCU代码逻辑.md)
3. [03 电机控制逻辑](./03_电机控制逻辑.md)
4. [04 当前进度与下一步](./04_当前进度与下一步.md)

如果只想先恢复全局印象，先看这页和 `01_数据流动链路.md`。如果要马上改代码，优先看 `02_MCU代码逻辑.md` 和 `03_电机控制逻辑.md`。

## 当前一句话状态

LADAR2 当前已经具备主链路闭环：LiDAR 通过 UART2 DMA 进入 MCU，MCU 结合编码器和电机速度估算每点时间/角度，再通过 CAN 双帧发给 Linux，上位机完成双帧重组、CSV 存储、CSV 回放和 XY 2D 点云显示。

项目现在的主要工作不是继续堆新功能，而是收口证据和文档：补 M3 恢复证据、统一 Linux 脚本入口命名、做 M5 长稳测试、再推进 M6/M7 的几何质量和展示材料。

## 核心文件地图

| 模块 | 文件 | 作用 |
| --- | --- | --- |
| 主入口和 ISR | `Core/Src/main.c` | HAL 初始化后进入 FreeRTOS；UART2 DMA IDLE 回调里生成 `LidarChunk` |
| FreeRTOS 任务 | `Core/Src/freertos.c` | 创建队列和任务；串联解析、电机、CAN、诊断任务 |
| LiDAR 解析 | `Core/Src/luna.c` | 通过 `LunaParseState` 状态机解析 TF-Luna 9 字节帧，过滤异常，估算 `t_sample_us` / `angle_tick` |
| 点结构 | `Core/Inc/main.h` | 定义 `lidar_point_t` 和 `LidarChunk` |
| CAN 协议 | `Core/Src/can.c` | 把一个点拆成 `0x123` / `0x124` 两帧发送 |
| 电机输出 | `Core/Src/motor.c` | 根据正负 PWM 设置方向 GPIO 和 TIM1 CCR |
| PID | `Core/Src/pid.c` | 速度闭环 PID，带输出限幅和抗积分饱和 |
| Linux 上位机 | `can_recv4.py` | SocketCAN 实时接收、双帧重组、CSV、回放、2D 点云 |
| 规格冻结 | `docs/spec_freeze/` | 字段、报文、时间戳和单位语义冻结 |
| 里程碑证据 | `docs/m1/` 到 `docs/m4/` | 采集、电机、CAN、Linux 闭环证据 |

## 当前最需要记住的设计约定

- 正式距离字段是 `distance_cm`，不是 `distance_mm`。
- MCU 时间是 `t_sample_us`，Linux 接收/重组时间是 `host_rx_time_us`，两者不能混用。
- `angle_tick` 是相对开机零位的单圈编码器计数，`angle_deg` 是由它派生出的角度。
- CAN 每个点发两帧：`0x123` 发距离/角度/质量，`0x124` 发时间/原始角度/状态。
- 当前异常帧策略是丢弃并计数：校验失败、低幅值、过近都不输出点。
- LiDAR parser 当前已具备显式状态机、checksum 失败滑动 1 字节重同步和内部诊断计数。
- 电机当前是单圈换向的双向闭环扫描，不是一直单方向旋转。
- Linux 侧已经具备实时接收和回放能力，文档入口已和当前 `can_recv4.py` 对齐。
