noodles-zip11/LADAR2-showcase/docs/m5/runs/m5_20260507_144251/baseline_metrics.md

# M5 基线指标页

| 指标 | 本次值 | 建议基线/判定 |
| --- | ---: | --- |
| 连续运行时长 | 0.0 s | 不少于 14400 s |
| CAN 重组点数 | 8 | 非 0，且运行中持续增长 |
| 丢包率 | 0.000000% | 先记录为基线；后续 M6/M7 不应显著变差 |
| 刷新率 | 1600.000 Hz | 先记录为基线；后续优化需对比 |
| 点间隔 p95 | 2.000 ms | 先记录为基线 |
| 最大点间隔 | 2.000 ms | 用于定位卡顿/断流 |
| 平均转速 | 4.392 rpm | 先记录为基线 |
| 转速标准差 | 0.468 rpm | 先记录为基线 |
| 转速 p95 偏差 | 0.741 rpm | 先记录为基线 |
