noodles-zip11/LADAR2-showcase/docs/m5/runs/m5_20260507_145736/baseline_metrics.md

# M5 基线指标页

| 指标 | 本次值 | 建议基线/判定 |
| --- | ---: | --- |
| 连续运行时长 | 6116.0 s | 短长稳基线；严格 4h 需不少于 14400 s |
| CAN 重组点数 | 612466 | 非 0，且运行中持续增长 |
| 丢包率 | 0.001143% | 先记录为基线；后续 M6/M7 不应显著变差 |
| 刷新率 | 100.147 Hz | 先记录为基线；后续优化需对比 |
| 点间隔 p95 | 18.482 ms | 先记录为基线 |
| 最大点间隔 | 1484.492 ms | 用于定位卡顿/断流 |
| 平均转速 | 9.026 rpm | 先记录为基线 |
| 转速标准差 | 1.485 rpm | 先记录为基线 |
| 转速 p95 偏差 | 3.887 rpm | 先记录为基线 |
