noodles-zip11/LADAR2-showcase/docs/m7/README.md

# M7 面试交付与 V1 封板

> 日期：2026-05-10
> 范围：第一阶段验收交付包
> 状态：文档包已准备；演示视频录制和 Git 标签仍需要用户执行

## 1. 目标

M7 的目标是把 LADAR2 第一阶段整理成可复现、可展示、可讲清楚的正式作品。这个阶段不再扩大功能范围，而是把已经完成的主链路、协议、证据、测试结论和边界统一收口到一个入口清晰的交付包。

## 2. 交付物索引

| 交付物 | 文件 | 状态 |
| --- | --- | --- |
| 根目录 README：运行方式、目录结构、依赖、演示路径和边界 | `README.md` | 已完成 |
| 系统框图、数据流图、时序图、CAN 表、CSV 字段表、时间戳表 | `docs/m7/01_system_diagrams.md` | 已完成 |
| 1 页项目总览 | `docs/m7/02_project_overview_one_page.md` | 已完成 |
| 面试讲稿与问答提纲 | `docs/m7/03_interview_talk_track.md` | 已完成 |
| 1 到 3 分钟演示视频脚本 | `docs/m7/04_demo_video_script.md` | 待录制 |
| V1 发布记录 | `docs/m7/05_v1_release_record.md` | 候选版已准备 |
| 简历版项目条目 | `docs/m7/06_resume_project_bullets.md` | 已完成 |

## 3. 证据来源

| 主题 | 主要证据 |
| --- | --- |
| 原始 LiDAR 与 CAN 采集 | `docs/m1/` |
| 电机稳速与角度配对 | `docs/m2/` |
| CAN 协议与诊断 | `docs/m3/`、`docs/spec_freeze/03_报文表.md` |
| 上位机接收、CSV、回放、UI | `docs/m4/` |
| 长稳基线 | `docs/m5/05_current_run_summary.md` |
| 几何质量 | `docs/m6/runs/m6_manual/geometry_metrics.md` |
| MQTT/plugin 扩展收口 | `docs/mqtt_plugin_refactor/08_m6_5_verification_record.md` |

## 4. M7 完成判断

从文档和面试交付角度看，M7 已经具备完成条件：

- README 已经说明项目定位、目录结构、运行命令、协议入口、演示路径和已知边界。
- 系统框图、数据流图和时序图已经集中到 M7 交付包。
- 验收叙述基于 M1-M6.5 已有证据，不伪造新测试结论。
- 面试讲稿覆盖角度同步、CAN 设计、上位机设计、稳定性证据和误差来源。
- 简历版项目条目已经压缩为可直接投递的工程表达，并保留 V1 边界。
- 视频脚本已经准备好，不需要再改代码即可录制。

## 5. 需要用户完成的事项

以下事项需要真实录屏、用户审阅或 Git 决策：

- 按 `04_demo_video_script.md` 录制 1 到 3 分钟演示视频。
- 审阅 M7 文档，确认表述符合你的面试风格。
- 提交最终 M7 文档包。
- 提交后再打标签，建议标签名：`v1.0.0`。

不要在提交这些文档前打标签，否则标签会指向不包含 M7 交付包的旧提交。
