noodles-zip11/LADAR2-showcase/docs/m5/runs/README.md

# M5 运行证据包目录

每次运行 `tools/m5_long_run.py` 会在本目录下创建：

```text
m5_YYYYMMDD_HHMMSS/
```

不要手工覆盖历史运行目录。短测、失败测试和正式 4h 测试都保留，方便复盘。
