noodles-zip11/LADAR2-showcase/docs/m8/datasets/known_scenes/m6_box_far_01/README.md

# M8 数据集条目

## 1. 基本信息

| 项目 | 内容 |
| --- | --- |
| 数据集名称 | `m6_box_far_01` |
| 来源 CSV | `LOCAL_USER_HOME\Desktop\雷达\LADAR2\docs\m6\runs\m6_manual\data\repeat_far_01.csv` |
| 场景标签 | `static_box` |
| 标签说明 | M6 known scene: far static box repeat 01 |
| 分类 | `known_scenes` |

## 2. 文件清单

| 文件 | 说明 |
| --- | --- |
| `m6_box_far_01.csv` | 原始 CSV 副本 |
| `m6_box_far_01.labels.csv` | 标签模板 |
| `m6_box_far_01.analysis.md` | 离线分析报告 |

## 3. 分析摘要

| 指标 | 结果 |
| --- | --- |
| `total_rows` | 3268 |
| `valid_points` | 3268 |
| `duration_s` | 33.4878 |
| `estimated_rate_hz` | 97.5579 |
| `distance_cm_median` | 34 |
| `distance_cm_p95` | 39 |
| `status_distribution` | {8: 3268} |
| `status_alert_count` | 0 |
| `estimated_flag_ratio` | 1 |
| `near_obstacle_count` | 3268 |
| `too_near_count` | 848 |
| `angle_coverage_ratio` | 1 |
| `outline_spread_cm_median` | 5.8 |

## 4. 采集摘要

| 字段 | 值 |
| --- | --- |
| `csv_path` | `LOCAL_USER_HOME\Desktop\雷达\LADAR2\docs\m6\runs\m6_manual\data\repeat_far_01.csv` |
| `generated_at` | `2026-05-10T15:45:34` |
| `reassembly_ok_point_cnt` | `3268` |
| `reassembly_timeout_point_cnt` | `1` |
| `reassembly_overwrite_a_cnt` | `0` |
| `reassembly_overwrite_b_cnt` | `0` |
| `pending_frame_cnt` | `0` |
| `reassembly_timeout_ms` | `50` |

## 5. 标签状态

当前标签为 `static_box`。未知场景保持 `unlabeled`；只有 M6 这类来源明确的数据才写入具体场景标签。
