noodles-zip11/LADAR2-showcase/docs/m8/datasets/replay_sets/can_distance_20260507_141150/README.md

# M8 数据集条目

## 1. 基本信息

| 项目 | 内容 |
| --- | --- |
| 数据集名称 | `can_distance_20260507_141150` |
| 来源 CSV | `LOCAL_USER_HOME\Desktop\雷达\LADAR2\can_distance_20260507_141150.csv` |
| 场景标签 | `unlabeled` |
| 标签说明 | unknown replay capture; scene is not claimed |
| 分类 | `replay_sets` |

## 2. 文件清单

| 文件 | 说明 |
| --- | --- |
| `can_distance_20260507_141150.csv` | 原始 CSV 副本 |
| `can_distance_20260507_141150.labels.csv` | 标签模板 |
| `can_distance_20260507_141150.analysis.md` | 离线分析报告 |

## 3. 分析摘要

| 指标 | 结果 |
| --- | --- |
| `total_rows` | 5220 |
| `valid_points` | 5220 |
| `duration_s` | 51.4775 |
| `estimated_rate_hz` | 101.384 |
| `distance_cm_median` | 49 |
| `distance_cm_p95` | 114 |
| `status_distribution` | {8: 5220} |
| `status_alert_count` | 0 |
| `estimated_flag_ratio` | 1 |
| `near_obstacle_count` | 2803 |
| `too_near_count` | 26 |
| `angle_coverage_ratio` | 1 |
| `outline_spread_cm_median` | 10 |

## 4. 采集摘要

未找到同名 `_summary.txt`。

## 5. 标签状态

当前标签为 `unlabeled`。未知场景保持 `unlabeled`；只有 M6 这类来源明确的数据才写入具体场景标签。
