noodles-zip11/LADAR2-showcase/docs/m3/04_联调与抓包记录.md

# M3 联调与抓包记录

## 1. 结论

截至 2026-03-28，M3 已完成一轮 Linux 侧正常链路联调，当前证据能够证明：

- MCU 正在持续发送 `0x123` 与 `0x124`
- Linux 接收端已经按 `seq` 成功完成双帧重组
- 重组后的点级 CSV 已经稳定落盘
- 最小重组统计已经能够输出 `ok / timeout / overwrite`

## 2. 本轮归档文件

- `docs/m3/data/candump_m3_normal.log`
- `docs/m3/data/can_distance_20260328_215800.csv`
- `docs/m3/data/can_distance_20260328_215800_summary.txt`

## 3. 抓包概况

### 3.1 candump 原始日志

文件：

- `docs/m3/data/candump_m3_normal.log`

统计：

- 总行数：`16630`
- `0x123` 报文：`8315`
- `0x124` 报文：`8315`

片段：

```text
(000.000000)  can0  123   [8]  98 00 25 42 B3 24 92 FF
(000.000273)  can0  124   [8]  98 04 AD A3 41 05 B7 08
(000.009888)  can0  123   [8]  99 00 25 42 B2 29 CC FF
(000.009983)  can0  124   [8]  99 04 AD CA 23 05 AF 08
```

说明：

- 两类报文数量完全配平
- 同一 `seq` 的 `0x123` / `0x124` 在时间上紧邻出现
- 这符合当前 M3 的双帧发送模型

### 3.2 Linux 重组 CSV

文件：

- `docs/m3/data/can_distance_20260328_215800.csv`

统计：

- 数据点数：`4719`
- 首条时间：`2026-03-28T21:58:00.386`
- 末条时间：`2026-03-28T21:58:54.531`
- 首条 `seq`：`16`
- 末条 `seq`：`99`

片段：

```text
host_time,elapsed_s,seq,distance_cm,angle_deg,quality,t_sample_us,angle_tick,status
2026-03-28T21:58:00.386,0.046,16,63,24.367346,255,344761231,398,8
2026-03-28T21:58:00.388,0.048,17,63,24.122450,255,344771201,394,8
2026-03-28T21:58:00.389,0.048,18,63,23.877550,255,344781142,390,8
```

说明：

- Linux 侧已经能输出完整点结构
- `distance_cm / angle_deg / quality / t_sample_us / angle_tick / status` 全部可用
- `status` 当前样例为 `8`，对应当前链路中的估算状态

### 3.3 Linux 重组统计摘要

文件：

- `docs/m3/data/can_distance_20260328_215800_summary.txt`

统计结果：

```text
reassembly_ok_point_cnt=4719
reassembly_timeout_point_cnt=1
reassembly_overwrite_a_cnt=0
reassembly_overwrite_b_cnt=0
reassembly_timeout_ms=50
```

说明：

- 正常链路下共成功重组 `4719` 个点
- 仅出现 `1` 次超时
- 没有出现同类帧覆盖
- 当前 Linux 重组器的基本行为已符合 M3 最小闭环目标

## 4. 当前边界

本页证明的是“正常链路联调已跑通”。M3 故障与恢复证据见 `05_错误统计与恢复样例.md` 和 `07_ACK故障恢复实测记录.md`。

当前不由本页覆盖、但已由其他 M3 文档覆盖的内容包括：

- MCU 正常态 `DiagLogTask` 样例
- MCU ACK fault -> recovery 板级实测样例
- `Bus-Off` 专项故障注入边界说明
