noodles-zip11/LADAR2-showcase/docs/m5/00_checkpoint_delivery.md

# M5 Checkpoint 交付物对照

## 1. 任务对照

| Checkpoint 项 | 当前落地方式 | 状态 |
| --- | --- | --- |
| 连续运行基线测试 | 本轮实际 `6116.0 s`，约 1h42min | 接受为 M6 前短长稳基线 |
| 记录丢包率 | `m5_20260507_145736` 报告写入 `0.001143%` | 已完成 |
| 记录刷新率 | `m5_20260507_145736` 报告写入 `100.147 Hz` | 已完成 |
| 记录转速波动 | `rpm_mean=9.026`，`rpm_std=1.485`，`rpm_p95_abs_delta=3.887` | 已完成 |
| 回填误差预算/基线指标 | `docs/m5/runs/m5_20260507_145736/baseline_metrics.md` | 已完成 |
| README | 根目录 `README.md` 和 `docs/m5/README.md` | 已更新 |
| 系统框图、数据流图、时序图 | `docs/m5/03_system_and_dataflow.md` | 已完成 |
| 测试记录 | `docs/m5/runs/m5_20260507_145736/test_record.md` | 已完成 |
| 演示素材 | `docs/m5/04_demo_materials.md` 固定清单；截图/视频可按需补 | 已准备 |

## 2. 当前交付包

当前可提交的短长稳基线目录：

```text
docs/m5/runs/m5_20260507_145736/
```

## 3. 当前证据边界

M5 正式 CAN 点云 CSV 不追加新字段，仍保持 M4 回放兼容。

本轮 M5 的交付重点是把主链路长稳、丢包率、刷新率和转速波动跑出来。当前接受 `m5_20260507_145736` 作为 M6 前短长稳基线，不再补跑 2h。对外表述时不写成“2h 长稳通过”，而写成“约 1h42min 短长稳基线”。
