noodles-zip11/LADAR2-showcase/docs/reacquaintance/04_当前进度与下一步.md

# 当前进度与下一步

更新时间：2026-04-20

本文综合 Notion 计划和仓库现状，重点回答“现在做到哪了，接下来该干什么”。

## 1. 进度总览

| 阶段 | Notion 状态 | 仓库证据 | 当前判断 |
| --- | --- | --- | --- |
| M0 规格冻结 | 已勾选完成 | `docs/spec_freeze/` 已有字段表、报文表、时间戳表 | 基本完成 |
| M1 采集与异常证据 | 已勾选完成 | `docs/m1/` 有原始帧、candump、CSV、截图、异常样例 | 基本完成 |
| M2 电机与同步 | 大部分完成，但 Notion 中误差预算项仍未勾 | `docs/m2/` 已有稳速验证、配对策略、误差预算；机械误差待实测 | 可按“非机械项完成”收口，仍缺机械实测 |
| M3 CAN 与诊断闭环 | Notion 任务多项已勾，但 callout 仍提示待补 | `docs/m3/` 已有诊断字段、错误模型、抓包、样例；README 已补充 LiDAR parser 状态机与内部诊断计数说明，仍有恢复证据和协议正文缺口 | 代码和最小证据已落地，完整收口未完成 |
| M4 Linux 闭环 | 已勾选完成 | `can_recv4.py`、`requirements.txt`、`docs/m4/`、示例 CSV/summary、截图/视频 | 功能上完成，但脚本入口文档需对齐 |
| M5 长稳收口 | 未完成 | 还没有 4h 长稳报告和统一证据包 | 下一阶段主任务 |
| M6 几何质量与同步优化 | 未完成 | 还没有重复性、闭合、直线度、漂移对比 | M5 后执行 |
| M7 面试交付与 V1 封板 | 文档交付已补齐 | `README.md` 和 `docs/m7/` 已补齐总览、系统图、数据流图、时序图、讲稿、视频脚本和 V1 发布记录 | 还需用户录制演示视频，并在提交后打 V1 标签 |
| M8+ 第二阶段扩展 | 未开始 | 无 | 等 M7 后再做 |

## 2. 已经做成的主链路

当前项目已经不是“单点功能调通”状态，而是有一条完整主链：

```text
LiDAR UART
-> MCU DMA chunk
-> LiDAR 帧解析
-> 时间戳/角度配对
-> CAN 双帧发送
-> Linux 双帧重组
-> CSV 存储
-> CSV 回放
-> XY 2D 点云显示
```

已有证据集中在：

- `docs/spec_freeze/`
- `docs/m1/`
- `docs/m2/`
- `docs/m3/`
- `docs/m4/`

## 3. 计划和仓库之间的差异

### 3.1 M2 误差预算状态不一致

Notion 中 M2 的“输出角度同步误差预算”仍是未勾选。

但仓库里已经有：

- `docs/m2/03_角度同步误差预算.md`
- `docs/m2/README.md` 中也说明非机械项已完成

更准确的说法是：

- 非机械项误差预算已完成。
- 机械误差实测值仍待补。
- 建议把 Notion 的 M2 状态改成“误差预算已完成，机械实测待补”，否则后续复盘容易误判。

### 3.2 M3 Notion 勾选偏乐观

Notion 中 M3 任务列表多项已勾选，但同一页 callout 又写了 M3 仍需补：

- 丢帧重组规则验证
- `DiagLogTask` 错误计数
- 队列高水位统计
- CAN 发送失败统计
- 总线错误与恢复行为
- 双节点联调闭环证据

仓库 `docs/m3/README.md` 的判断更细：

- MCU 统计埋点已经落地
- LiDAR parser 已完成内部拆分、滑动重同步和显式 `LunaParseState` 状态机收口
- `DiagLogTask` 已有正常/故障样例
- Linux 最小重组闭环已完成
- 仍缺 `Bus-Off -> recovery` 板级实测证据
- 协议正文还需要补 Linux 双帧超时、覆盖、`seq` 回绕规则

所以 M3 现在应按“实现基本完成，证据和协议收口待补”处理。

### 3.3 M4 脚本入口不一致

`docs/m4/README.md` 里写的入口是 `can_recv4.py`。

当前仓库根目录实际看到的是：

- `can_recv4.py`
- `requirements.txt`

这说明 M4 文档和实际脚本命名已经漂移。建议下一步先统一：

- 要么把文档改成 `can_recv4.py`
- 要么确认历史 `can_recv4.py` 是否应保留或重命名

当前不要忽略这个问题，因为它会直接影响项目复现和面试演示。

## 4. 当前最该做的事项

### P0：统一 M4 Linux 入口

目标：让 README、M4 文档、实际文件名一致。

建议动作：

- 确认正式入口是否就是 `can_recv4.py`
- 修改 `docs/m4/README.md` 中所有 `can_recv4.py`
- 在总 README 中写清实时和回放命令

验收标准：

```bash
python3 can_recv4.py --mode live --channel can0
python3 can_recv4.py --mode replay --input-csv docs/m4/data/can_distance_v2_sample.csv
```

### P0：补 M3 恢复证据和协议正文

目标：让 M3 从“代码打通”变成“闭环可证明”。

建议动作：

- 采一份 `diag_m3_fault_recovery.csv`
- 证明 `can_bus_off_cnt` 和 `can_recovery_cnt` 的真实变化
- 把 Linux 重组规则正式写入 `docs/spec_freeze/03_报文表.md`
- 明确：
  - 双帧超时 50 ms
  - 同 seq 同类型帧覆盖计数
  - `seq` 256 回绕
  - 缺任一帧则该点不输出

### P1：做 M5 4h 长稳

目标：进入第一阶段收口。

需要记录：

- 运行时长不少于 4h
- 丢包率
- 刷新率
- 温升
- 转速波动
- 异常恢复次数
- CAN 错误统计
- 队列高水位

建议产物：

- `docs/m5/README.md`
- `docs/m5/data/long_run_*.csv`
- `docs/m5/data/diag_long_run_*.csv`
- `docs/m5/assets/`

### P1：补 M2 机械误差实测

目标：让 M2 误差预算完整闭合。

建议动作：

- 固定墙面或固定目标
- 同一位置多圈重复采样
- 统计角度/边缘位置重复性
- 回填 `docs/m2/03_角度同步误差预算.md`

### P2：推进 M6 几何质量

M6 应该在 M5 长稳后做。

验证项：

- 静态场景 3 次重复采样
- 一圈首尾闭合
- 墙面直线度
- 长时间运行前后轮廓漂移
- 配对时刻、转速波动、安装偏心、异常点过滤、显示连线策略逐项排查

### P2：M7 面试交付与 V1 封板

M7 文档交付已经补齐，入口集中在：

- 根目录 `README.md`
- `docs/m7/README.md`
- `docs/m7/01_system_diagrams.md`
- `docs/m7/02_project_overview_one_page.md`
- `docs/m7/03_interview_talk_track.md`
- `docs/m7/04_demo_video_script.md`
- `docs/m7/05_v1_release_record.md`

当前剩余事项：

- 按 `docs/m7/04_demo_video_script.md` 录制 1 到 3 分钟演示视频。
- 审阅并提交 M7 文档包。
- 提交后再打 `v1.0.0` 标签，避免标签指向不包含 M7 文档的旧提交。

## 5. 不建议现在做的事

- 不建议现在先做 MQTT、云端上传或 IoT 包装。Notion 也明确这些应在 V1 主链路稳定后再考虑。
- 不建议在 M3/M5 证据没补齐前继续大改协议。
- 不建议把 `distance_cm` 改成 `distance_mm`。规格冻结已经决定正式字段是 `distance_cm`。
- 不建议把 `host_rx_time_us` 当成 MCU 采样时间使用。

## 6. 当前最短恢复路径

如果你今天只想快速重新上手，按这个顺序做：

1. 读 [01 数据流动链路](./01_数据流动链路.md)，恢复主链路。
2. 读 [03 电机控制逻辑](./03_电机控制逻辑.md)，恢复 M2 的控制策略。
3. 打开 `can_recv4.py`，确认当前 Linux 正式入口。
4. 打开 `docs/m3/README.md`，看 M3 缺口。
5. 先做“统一 M4 入口 + 补 M3 恢复证据”，再进入 M5 长稳。
