noodles-zip11/LADAR2-showcase/docs/m8/datasets/replay_sets/can_distance_20260509_223115/can_distance_20260509_223115.analysis.md

# M8 离线分析报告

- 输入文件：`LOCAL_USER_HOME\Desktop\雷达\LADAR2\docs\m8\datasets\replay_sets\can_distance_20260509_223115\can_distance_20260509_223115.csv`
- 字段：`host_rx_time_us, t_sample_us, angle_tick, angle_deg, distance_cm, x_mm, y_mm, quality, status`

## 基础指标

| 指标 | 结果 |
| --- | --- |
| `total_rows` | 8691 |
| `valid_points` | 8691 |
| `invalid_rows` | 0 |
| `duration_s` | 86.5127 |
| `estimated_rate_hz` | 100.448 |
| `distance_cm_min` | 28 |
| `distance_cm_median` | 45 |
| `distance_cm_p95` | 184 |
| `distance_cm_max` | 285 |
| `quality_median` | 255 |
| `quality_min` | 171 |
| `low_quality_count` | 0 |
| `status_distribution` | {8: 8691} |
| `status_alert_distribution` | {0: 8691} |
| `status_alert_count` | 0 |
| `estimated_flag_count` | 8691 |
| `estimated_flag_ratio` | 1 |
| `near_obstacle_count` | 5036 |
| `too_near_count` | 268 |
| `anomaly_candidate_count` | 0 |
| `anomaly_candidate_ratio` | 0 |
| `angle_bin_deg` | 10 |
| `angle_bin_count` | 36 |
| `angle_coverage_ratio` | 1 |
| `angle_bin_min_points` | 201 |
| `angle_bin_max_points` | 543 |
| `outline_usable_bins` | 36 |
| `outline_spread_cm_median` | 16 |
| `outline_spread_cm_p95` | 177.587 |

## 标签分布

| 标签 | 片段数 |
| --- | --- |
| `unlabeled` | 1 |

## 口径说明

- `status & 0x07` 表示告警等级；仅该低 3 位非零时计入 `status_alert_count`。
- `status=0x08` 是 estimated 标记，不单独视为异常。
- `anomaly_candidate_ratio` 是离线筛查指标，不等同于人工场景标签或最终算法判定。
- `outline_spread_cm_*` 是按角度分箱统计的距离离散程度，只用于粗看轮廓稳定性。
