noodles-zip11/LADAR2-showcase/docs/m1/assets/candump_capture.png

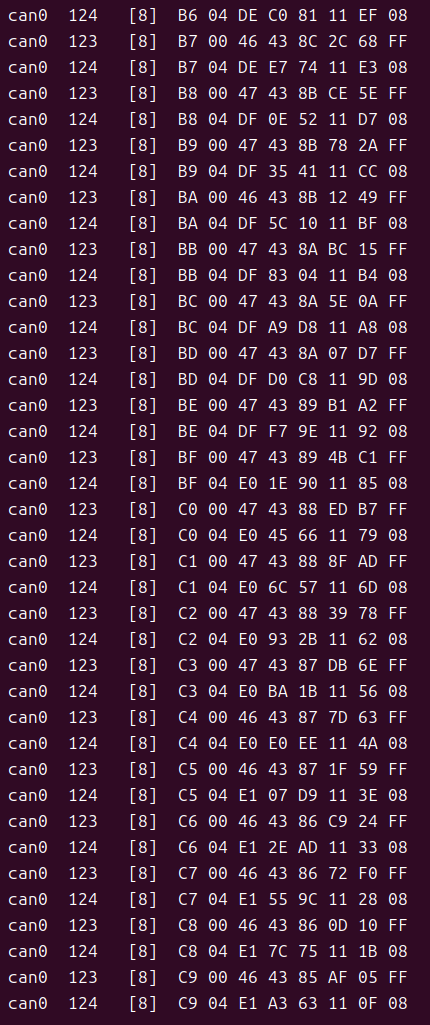
docs/m1/assets/candump_capture.png
