noodles-zip11/LADAR2-showcase/docs/m1/assets/linux_receiver_terminal.png

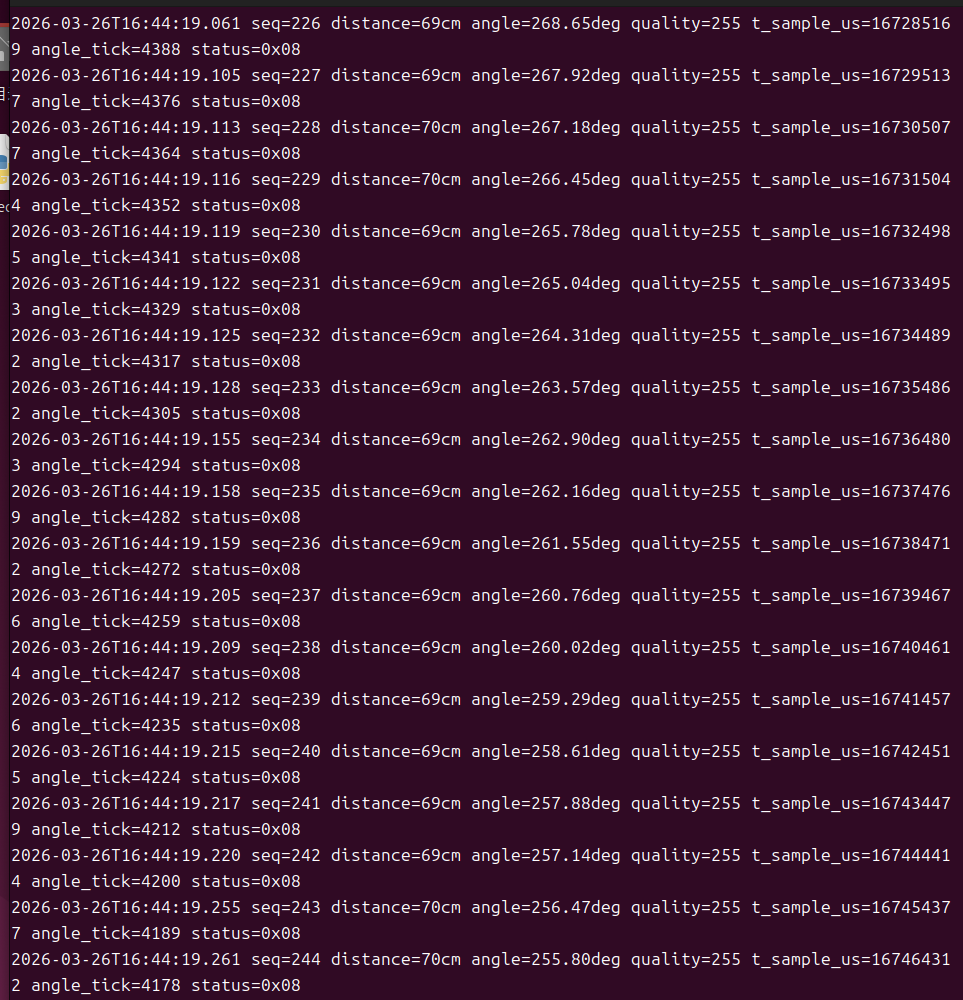
docs/m1/assets/linux_receiver_terminal.png
