noodles-zip11/LADAR2-showcase/docs/m9/runs/rule_based_v1/known_scenes/m6_box_far_02/m6_box_far_02.m9_compare.png

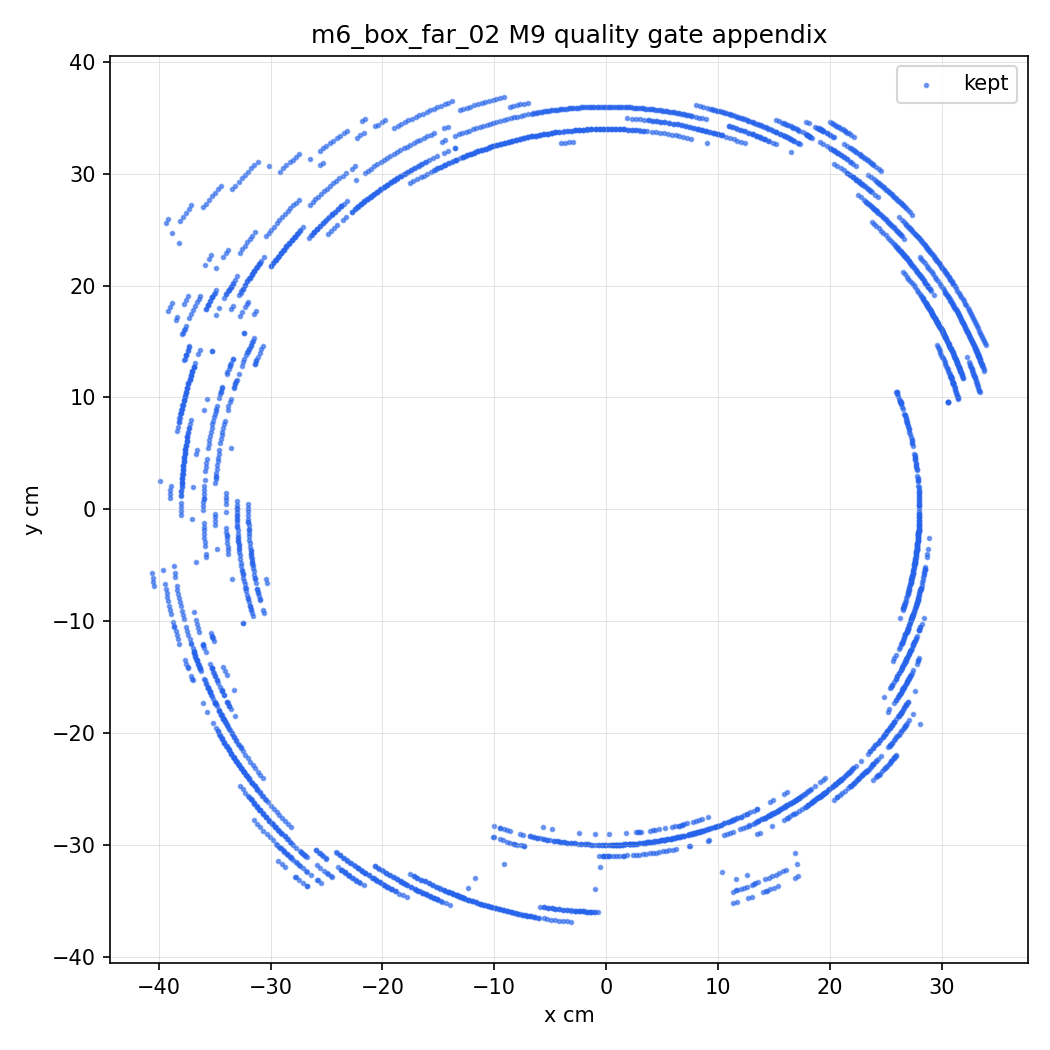
docs/m9/runs/rule_based_v1/known_scenes/m6_box_far_02/m6_box_far_02.m9_compare.png
