noodles-zip11/LADAR2-showcase/docs/m9/runs/rule_based_v1/known_scenes_contact_sheet.png

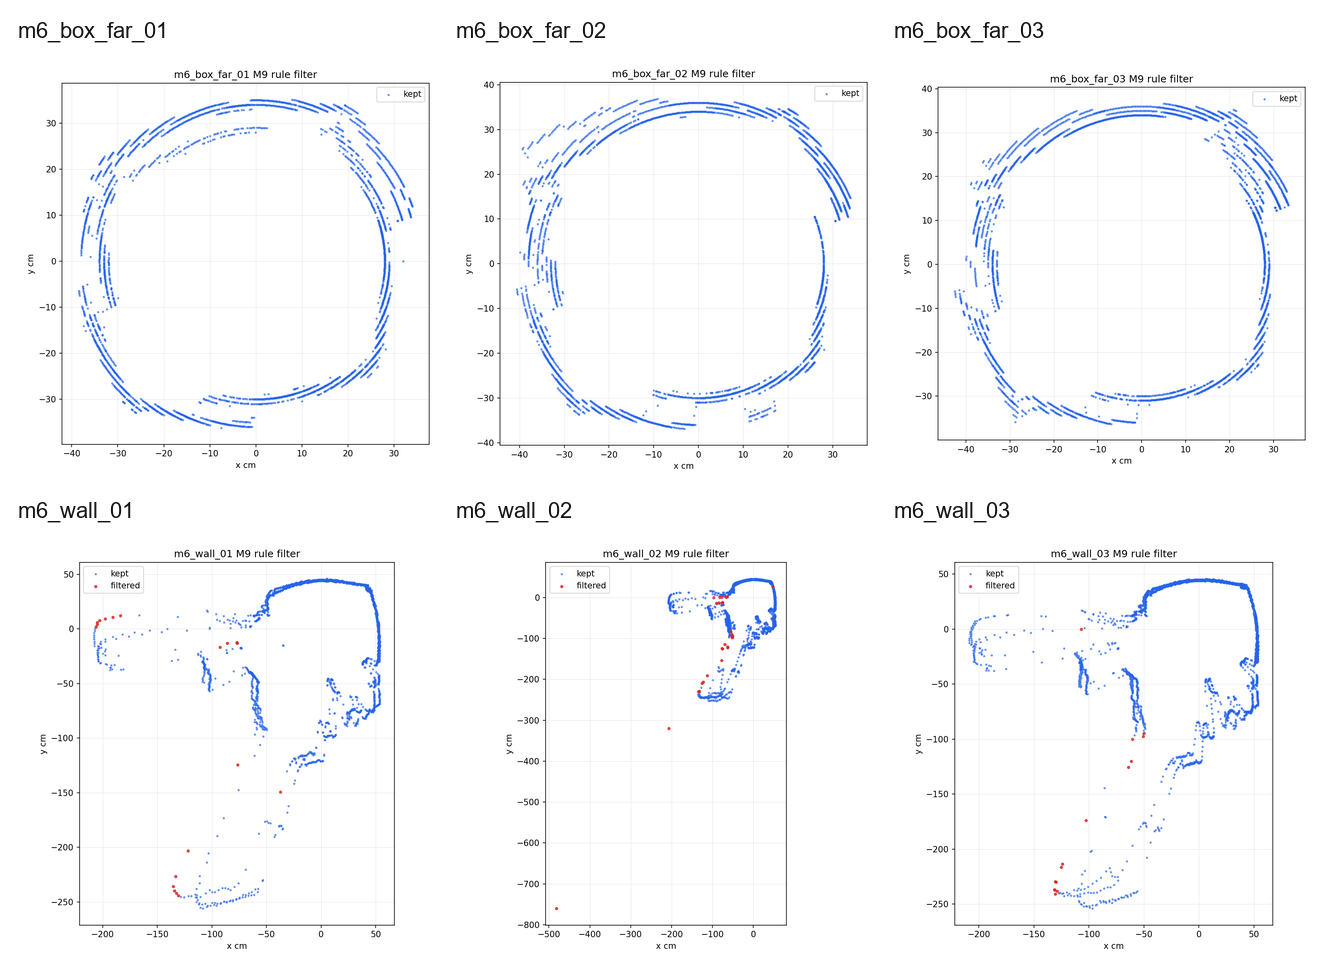
docs/m9/runs/rule_based_v1/known_scenes_contact_sheet.png
