noodles-zip11/LADAR2-showcase/docs/m9/runs/rule_based_v1/m6_wall_01_wall_roi.png

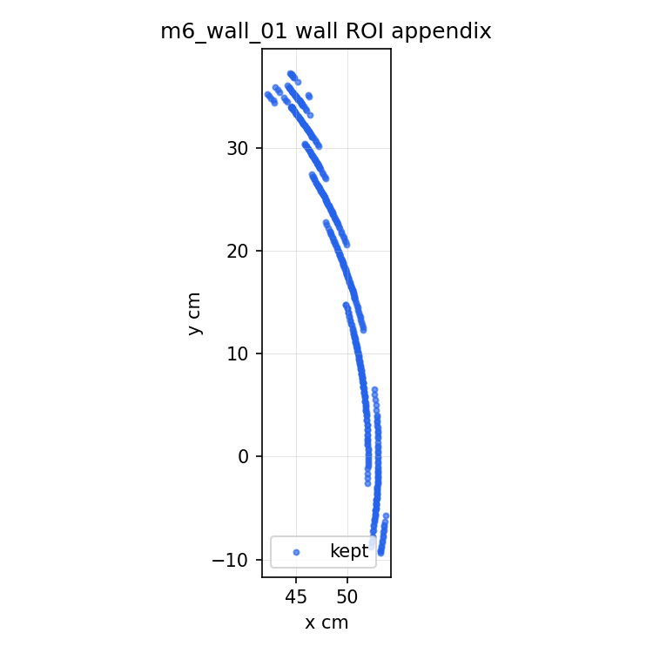
docs/m9/runs/rule_based_v1/m6_wall_01_wall_roi.png
