noodles-zip11/LADAR2-showcase/docs/m9/runs/rule_based_v1/replay_sets/can_distance_20260509_223115/can_distance_20260509_223115.m9_compare.png

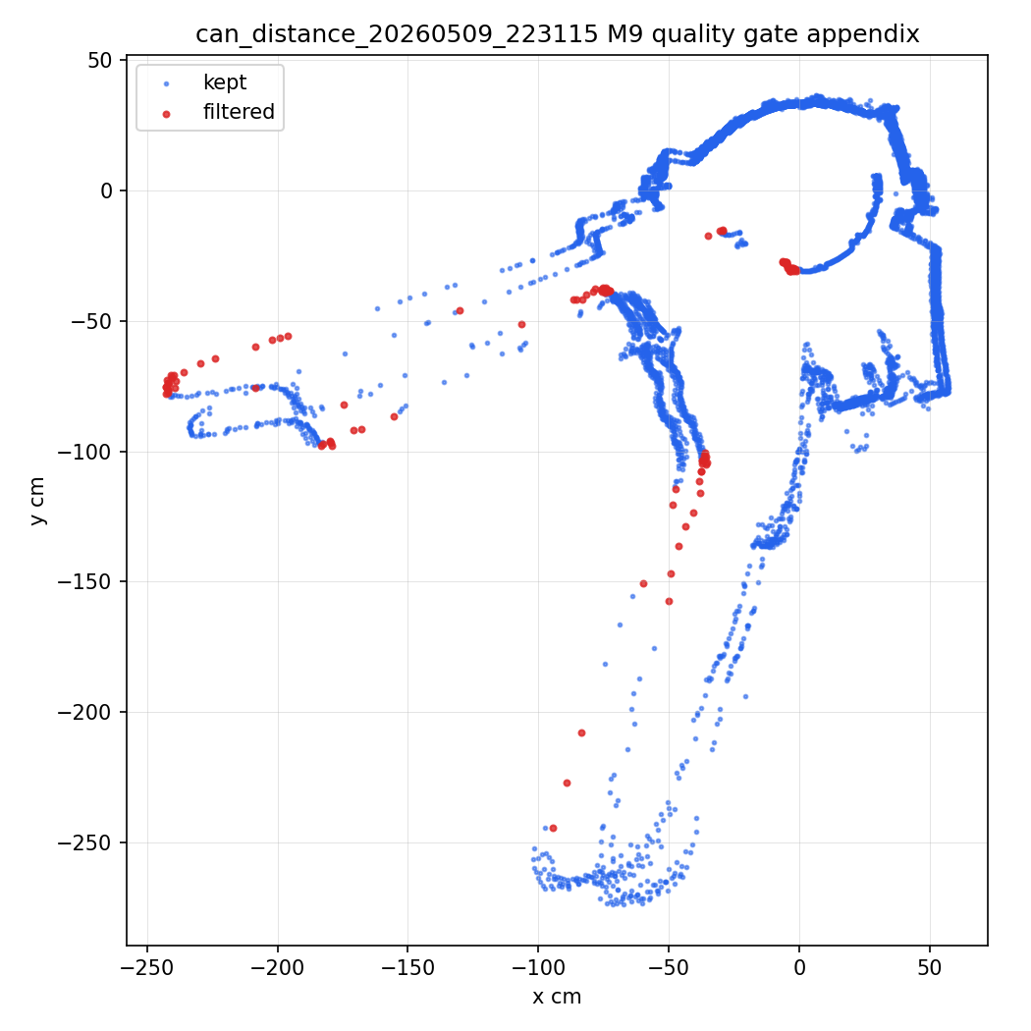
docs/m9/runs/rule_based_v1/replay_sets/can_distance_20260509_223115/can_distance_20260509_223115.m9_compare.png
