noodles-zip11/LADAR2-showcase/docs/m9/runs/rule_based_v1/replay_sets/can_distance_20260510_000136/can_distance_20260510_000136.m9_compare.png

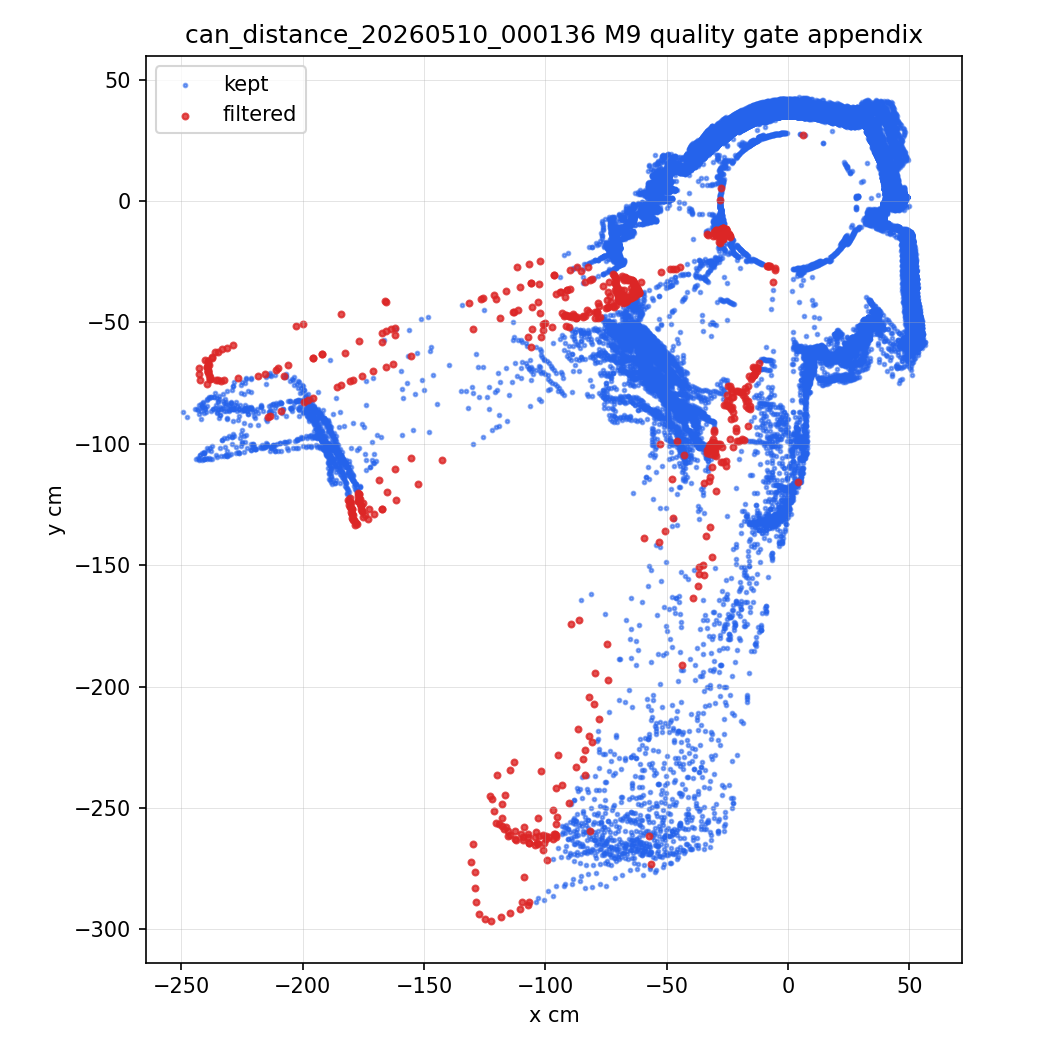
docs/m9/runs/rule_based_v1/replay_sets/can_distance_20260510_000136/can_distance_20260510_000136.m9_compare.png
