noodles-zip11/LADAR2-showcase/docs/mqtt_plugin_refactor/ui_replay_offscreen.png

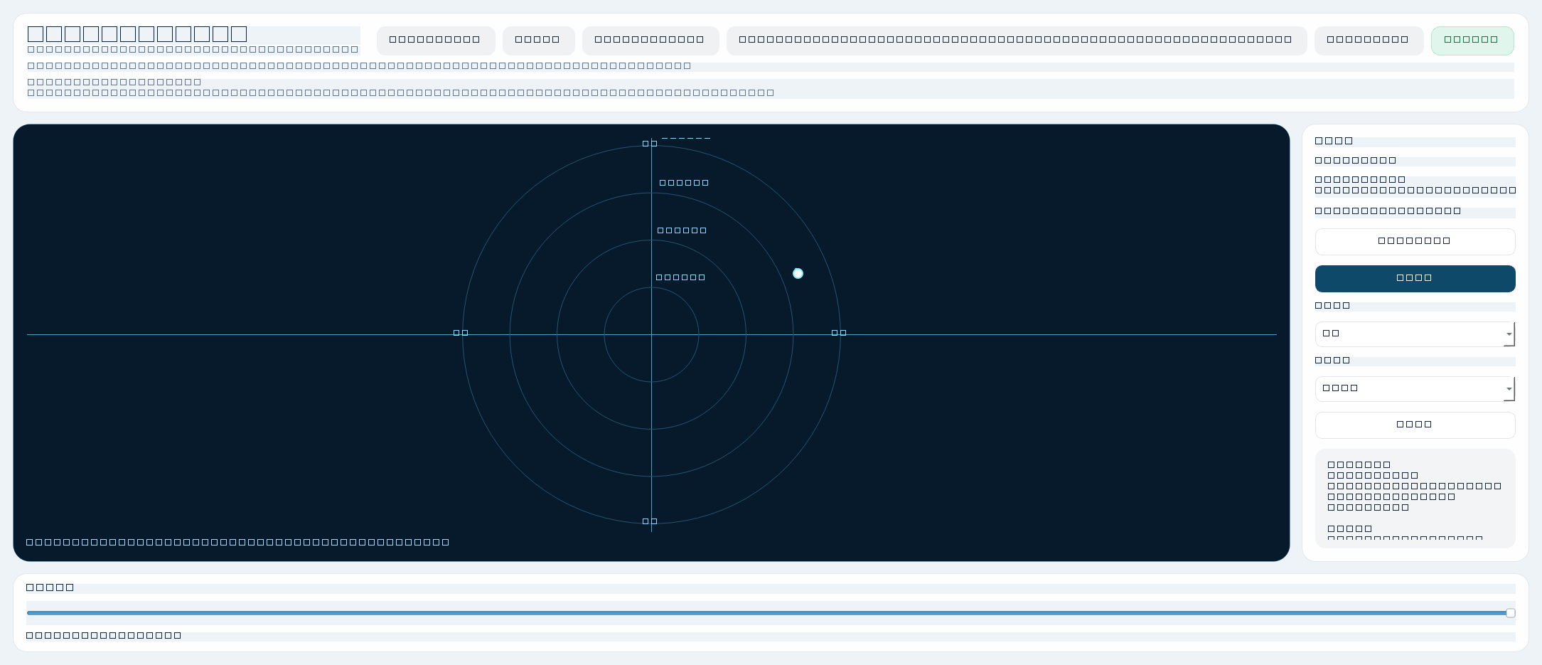
docs/mqtt_plugin_refactor/ui_replay_offscreen.png
