noodles-zip11/LADAR2-showcase/docs/m6/runs/m6_manual/assets/box_far_seam_closeup.png

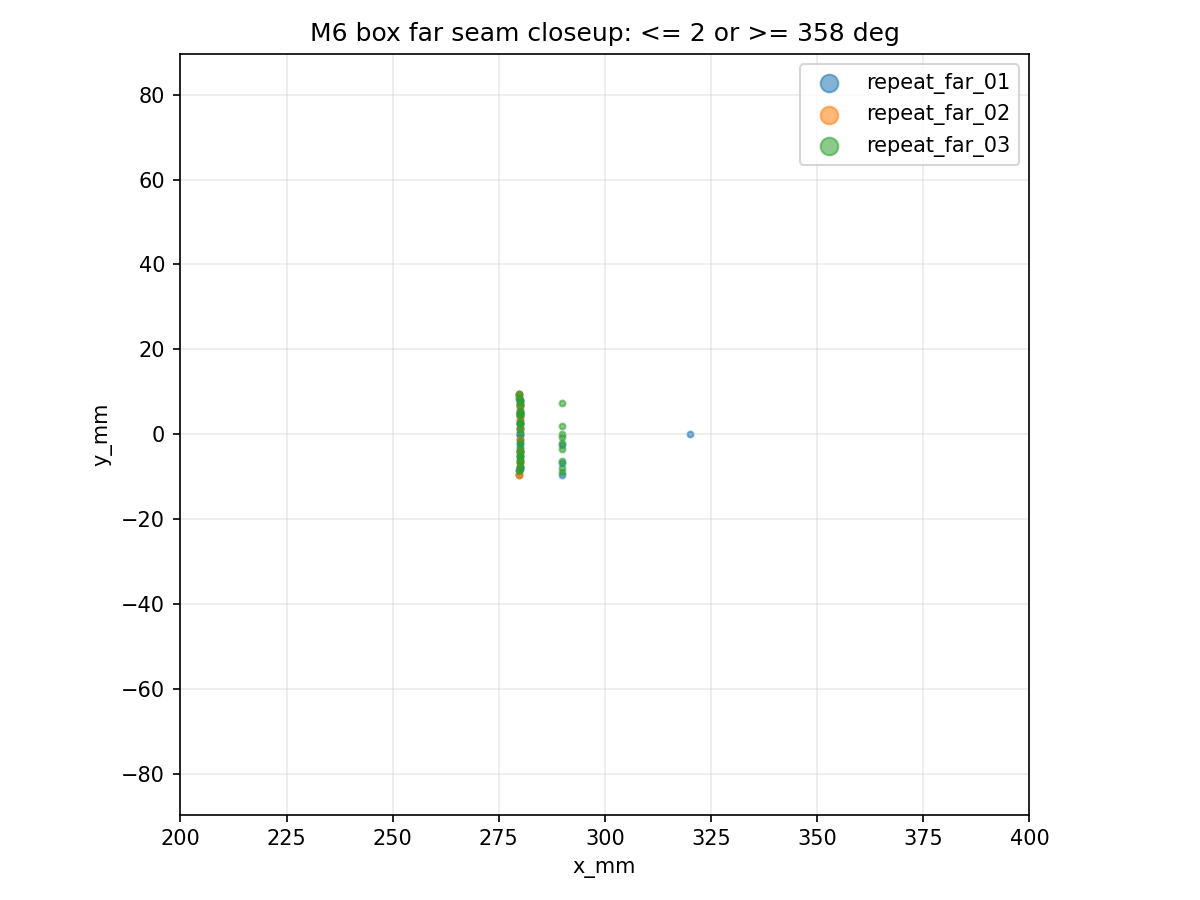
docs/m6/runs/m6_manual/assets/box_far_seam_closeup.png
