noodles-zip11/LADAR2-showcase/docs/m6/runs/m6_manual/assets/line_fit.png

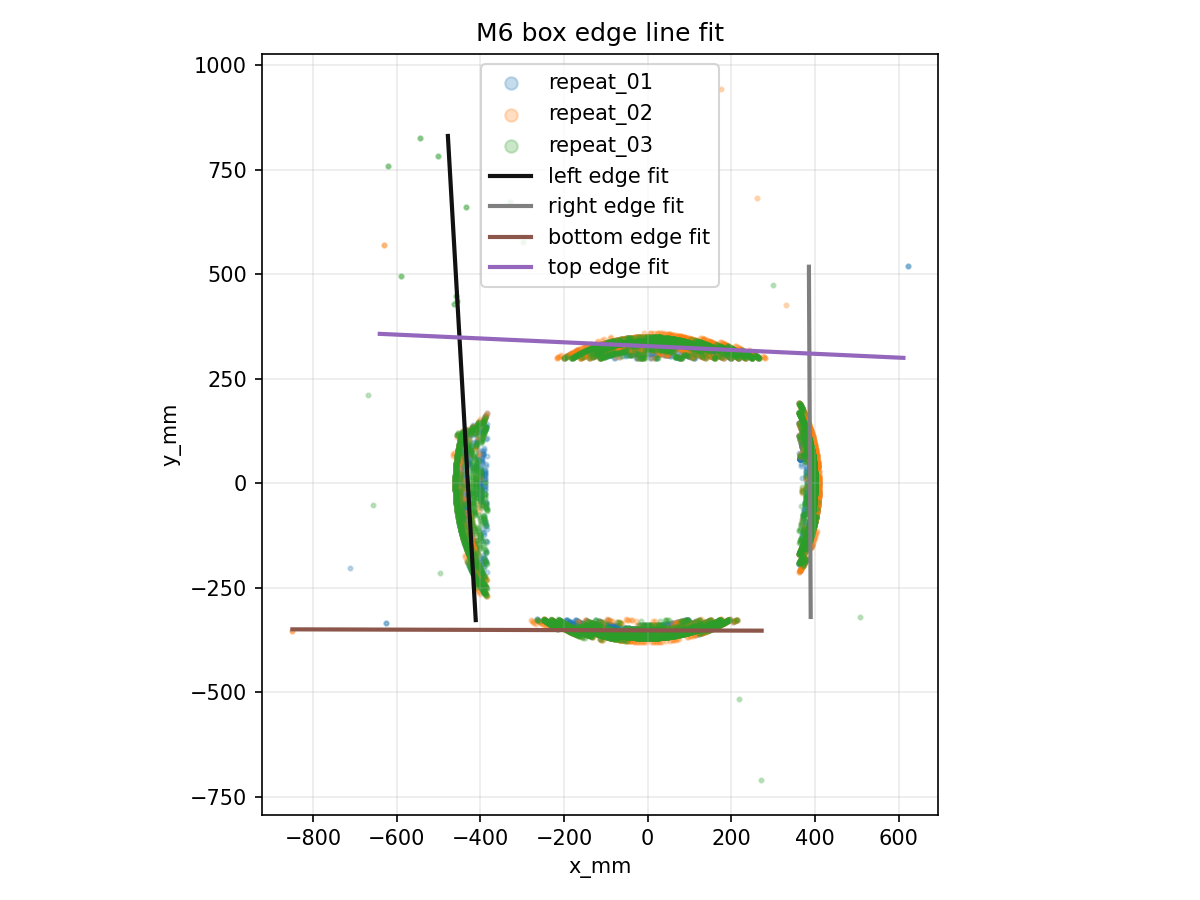
docs/m6/runs/m6_manual/assets/line_fit.png
