noodles-zip11/LADAR2-showcase/docs/m6/runs/m6_manual/assets/repeat_overlay.png

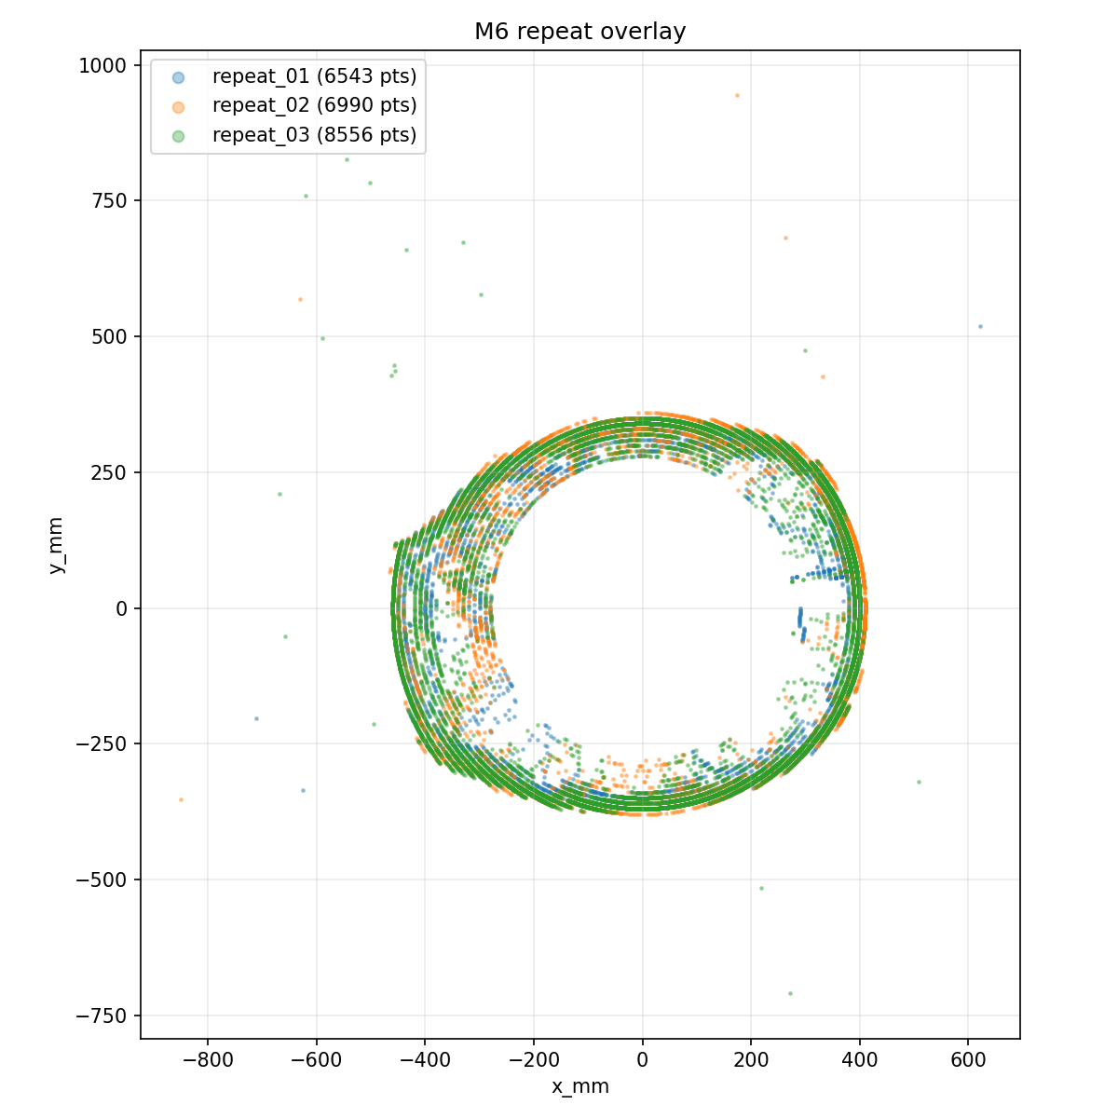
docs/m6/runs/m6_manual/assets/repeat_overlay.png
