noodles-zip11/LADAR2-showcase/docs/mqtt_plugin_refactor/phase_b_smoke_test_log.txt

MQTT 烟雾测试 — broker=localhost:1883 client_id=ladar2_smoke_test

[OK] 已连接 MQTT broker (rc=0)
[PUB] status → lidar/01/status: {"device_id": "lidar-01", "state": "online", "mode": "live", "version": "1.0.0", "ts": 1778343405394}
[SUB] 已订阅 lidar/01/cmd
[PUB] 消息已确认 mid=1
[CMD] ← topic=lidar/01/cmd qos=1 payload={"cmd": "ping", "req_id": "t01"}
[PUB] telemetry → lidar/01/telemetry: {"device_id": "lidar-01", "mode": "live", "ts": 1778343405695, "point_count": 42, "sweep_point_count": 18, "min_distance_cm": 15, "min_distance_angle_deg": 90.5, "latest_quality": 12, "latest_status": 0, "reassembly": {"ok": 100, "timeout": 0, "overwrite_a": 0, "overwrite_b": 0, "pending": 0}}

================================================================
  最小闭环已就绪。请在另一个终端发送命令验证:
    mosquitto_pub -t 'lidar/01/cmd' -m '{"cmd":"ping"}' -q 1
================================================================

等待命令中... (15s 后自动退出)
[PUB] 消息已确认 mid=3
[CMD] ← topic=lidar/01/cmd qos=1 payload={"cmd": "ping", "req_id": "t02"}
(duration reached, exiting)

正在退出...
[PUB] status offline → lidar/01/status: {"device_id": "lidar-01", "state": "offline"}
[PUB] 消息已确认 mid=4
[OK] 正常断开连接
[OK] 烟雾测试结束
