noodles-zip11/LADAR2-showcase/docs/mqtt_plugin_refactor/03_topic_interface_and_test_v2.md

# ⚠ 已废弃

本文档为历史草稿，已废弃。正式合同文件请参见 [03_topic_interface_and_test.md](./03_topic_interface_and_test.md)。请勿引用本文件。
