noodles-zip11/LADAR2-showcase/docs/m5/runs/m5_20260507_144251/test_record.md

# M5 测试记录

## 基本信息

| 项目 | 记录 |
| --- | --- |
| run_id | `m5_20260507_144251` |
| 操作人 | project_author |
| 采集命令 | `.\tools\m5_long_run.py --input-csv .\docs\m4\data\can_distance_v2_sample.csv --duration-s 0` |
| CAN backend | `NA` |
| CAN channel | `NA` |
| bitrate | `NA` |

## 检查点

- [ ] 连续运行不少于 4h
- [ ] CAN 点云 CSV 可回放
- [ ] 丢包率已统计
- [ ] 刷新率已统计
- [ ] 转速波动已统计
- [ ] 关键日志和数据样例已归档

## 结论

待人工复核本目录下报告和截图后填写最终结论。
