noodles-zip11/LADAR2-showcase/docs/m6/runs/m6_manual/tuning_scan.csv

score | angle_offset_deg | box_min_distance_mm | box_max_distance_mm | gap_threshold_mm | box_repeatability_p95_mm | box_seam_gap_mm | box_edge_rmse_mm | box_gap_count | wall_line_rmse_mm | wall_residual_p95_mm | wall_repeat_offset_mm | wall_gap_count
22.300780094519194 | 3.0 | 280.0 | 1000.0 | 120.0 | 20.0 | 10.631583209399922 | 15.687621773579204 | 3 | 7.435033007558866 | 13.089053429699549 | 6.338692188763333 | 5
22.350780094519195 | 3.0 | 280.0 | 1000.0 | 80.0 | 20.0 | 10.631583209399922 | 15.687621773579204 | 3 | 7.435033007558866 | 13.089053429699549 | 6.338692188763333 | 6
22.59864573832806 | 2.0 | 280.0 | 1000.0 | 120.0 | 20.0 | 9.800108698194549 | 16.068634868508603 | 3 | 7.43503300755887 | 13.089053429699614 | 6.327881174811099 | 5
22.64864573832806 | 2.0 | 280.0 | 1000.0 | 80.0 | 20.0 | 9.800108698194549 | 16.068634868508603 | 3 | 7.43503300755887 | 13.089053429699614 | 6.327881174811099 | 6
22.833501983303318 | 1.0 | 280.0 | 1000.0 | 120.0 | 20.0 | 10.47136665626102 | 16.236365317677215 | 3 | 7.4350330075588715 | 13.089053429699248 | 6.318889906700884 | 5
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
