noodles-zip11/LADAR2-showcase/docs/m1/assets/lidar_raw_chunk_debug.png

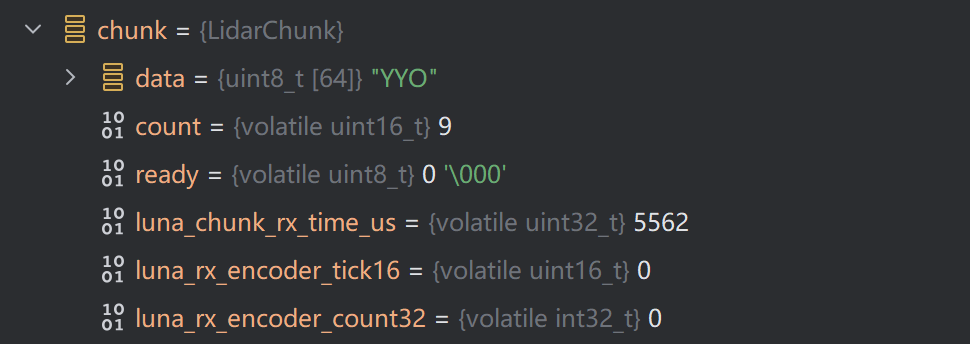
docs/m1/assets/lidar_raw_chunk_debug.png
