noodles-zip11/LADAR2-showcase/LADAR2.ioc

Mcu.UserName=STM32F407VETx
PA0-WKUP.Signal=S_TIM2_CH1_ETR
PA1.Signal=S_TIM2_CH2
PA11.Signal=CAN1_RX
PA12.Signal=CAN1_TX
PA13.Signal=SYS_JTMS-SWDIO
PA14.Signal=SYS_JTCK-SWCLK
PA2.Signal=USART2_TX
PA3.Signal=USART2_RX
PA6.Signal=GPIO_Output
PA7.Signal=GPIO_Output
PB10.Signal=USART3_TX
PB11.Signal=USART3_RX
PC0.Signal=GPIO_Output
PC1.Signal=GPIO_Output
PC2.Signal=GPIO_Output
PE9.Signal=S_TIM1_CH1
